akreager/cartreader/README.md

   

# Open Source Cartridge Reader
This project represents a community-driven effort to provide an easy to build and easy to modify cartridge dumper.     
Its main purpose is to dump a video game's ROM and save file to an SD card without the need of a PC.    

For any questions you can use the [Discussions](https://github.com/sanni/cartreader/discussions) and/or [Issues](https://github.com/sanni/cartreader/issues) section here on Github or visit the accompanying thread in the [Arduino Forum](http://forum.arduino.cc/index.php?topic=158974.9001), where you can reach most of the devs directly.    

Also be sure to check the guides in the [Wiki](https://github.com/sanni/cartreader/wiki) too.    

Happy making. 🔧🔨😊    

   

#### Features:  
- Modular design   
- Stand-alone operation  
- Easy to modify open-source code      
- Portable when used together with a power bank  

   

#### Supported Systems:    
- NES/Famicom/Family Basic   
- SNES/Super Famicom (including SF Memory and Satellaview)  
- N64 (including Controller Pak and Gameshark)     
- Game Boy Color (including GB Memory)  
- Game Boy Advance    
- Sega Mega Drive/Genesis    
- Sega Master System   

  

#### Supported with adapters:    
- Virtual Boy    
- Sega Game Gear    
- Sega Mark III     
- Sega SG-1000    
- Sega Cards    
- PC engine/TG16    
- WonderSwan    
- NeoGeo Pocket    
- Intellivision   
- ColecoVision    
- Benesse Pocket Challenge W    
- Watara Supervision    
- Atari 2600    
- Emerson Arcadia 2001   
- Fairchild Channel F     
- Magnavox Odyssey 2     

#### Open Source Licenses:    
- Software(everything in Cart_Reader folder) = GPL v3   
- Hardware(everything in hardware folder) = CC-BY-4.0
