akreager/cartreader/hardware/main_pcb_hw5/main_pcb_hw5.kicad_pcb

## KiCad design hardware/main_pcb_hw5/main_pcb_hw5.kicad_pcb (2023-01-22)

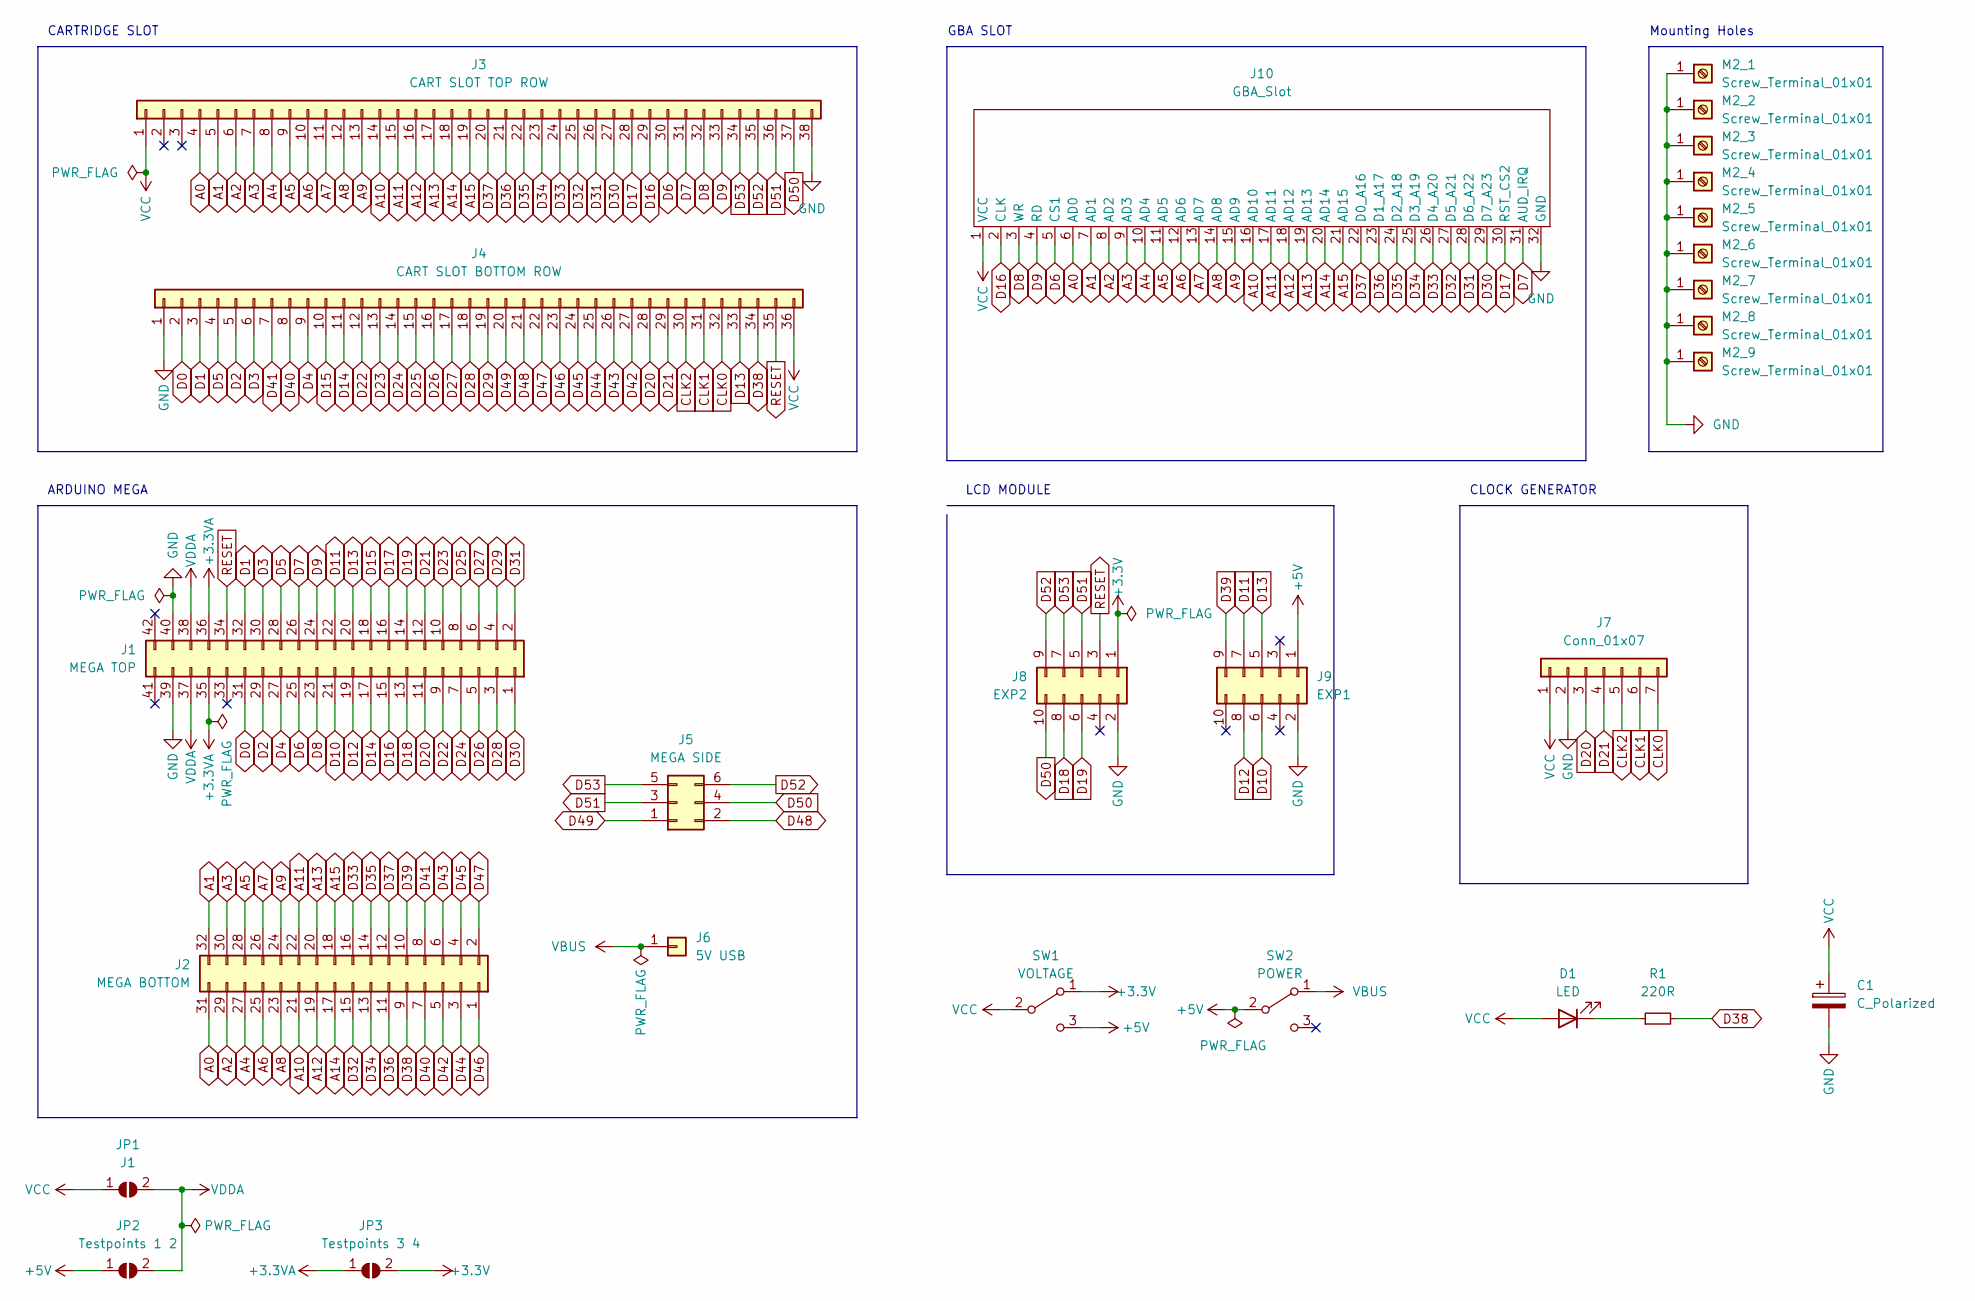
[picture p1: schematic main_pcb_hw5.kicad_sch, OSCR HW5]

Parts:
C1: C_Polarized; CP_Radial_D8.0mm_P3.50mm
D1: LED; LED_D3.0mm
J1: MEGA TOP; PinSocket_2x21_P2.54mm_Vertical
J2: MEGA BOTTOM; PinSocket_2x16_P2.54mm_Vertical
J3: CART SLOT TOP ROW; PinSocket_1x38_P2.54mm_Vertical
J4: CART SLOT BOTTOM ROW; PinSocket_1x36_P2.54mm_Vertical
J5: MEGA SIDE; PinSocket_2x03_P2.54mm_Vertical
J6: 5V USB; PinHeader_1x01_P2.54mm_Vertical
J7: Conn_01x07; PinHeader_1x07_P2.54mm_Vertical
J8: EXP2; IDC-Header_2x05_P2.54mm_Vertical
J9: EXP1; IDC-Header_2x05_P2.54mm_Vertical
J10: GBA_Slot
JP1: J1; SolderJumper-2_P1.3mm_Open_Pad1.0x1.5mm
JP2: Testpoints 1 2; SolderJumper-2_P1.3mm_Open_Pad1.0x1.5mm
JP3: Testpoints 3 4; SolderJumper-2_P1.3mm_Open_Pad1.0x1.5mm
M2_1, M2_2, M2_3, M2_4, M2_5, M2_6, M2_7, M2_8, M2_9: Screw_Terminal_01x01; MountingHole_2.2mm_M2_ISO7380_Pad
R1: 220R; R_Axial_DIN0207_L6.3mm_D2.5mm_P10.16mm_Horizontal
SW1: VOLTAGE; SW_CuK_OS102011MA1QN1_SPDT_Angled
SW2: POWER; SW_CuK_OS102011MA1QN1_SPDT_Angled

Connections:
+3.3VA: J1.35, J1.36, JP3.1 (A)
+3V3: J8.1, JP3.2 (B), SW1.1 (A)
+5V: J9.1, JP2.1 (A), SW1.3 (C), SW2.2 (B)
A0: J2.31, J3.4, J10.6 (AD0)
A1: J2.32, J3.5, J10.7 (AD1)
A2: J2.29, J3.6, J10.8 (AD2)
A3: J2.30, J3.7, J10.9 (AD3)
A4: J2.27, J3.8, J10.10 (AD4)
A5: J2.28, J3.9, J10.11 (AD5)
A6: J2.25, J3.10, J10.12 (AD6)
A7: J2.26, J3.11, J10.13 (AD7)
A8: J2.23, J3.12, J10.14 (AD8)
A9: J2.24, J3.13, J10.15 (AD9)
A10: J2.21, J3.14, J10.16 (AD10)
A11: J2.22, J3.15, J10.17 (AD11)
A12: J2.19, J3.16, J10.18 (AD12)
A13: J2.20, J3.17, J10.19 (AD13)
A14: J2.17, J3.18, J10.20 (AD14)
A15: J2.18, J3.19, J10.21 (AD15)
CLK0: J4.32, J7.7
CLK1: J4.31, J7.6
CLK2: J4.30, J7.5
D0: J1.31, J4.2
D1: J1.32, J4.3
D2: J1.29, J4.5
D3: J1.30, J4.6
D4: J1.27, J4.9
D5: J1.28, J4.4
D6: J1.25, J3.30, J10.5 (CS1)
D7: J1.26, J3.31, J10.31 (AUD_IRQ)
D8: J1.23, J3.32, J10.3 (WR)
D9: J1.24, J3.33, J10.4 (RD)
D10: J1.21, J9.6
D11: J1.22, J9.7
D12: J1.19, J9.8
D13: J1.20, J4.33, J9.5
D14: J1.17, J4.11
D15: J1.18, J4.10
D16: J1.15, J3.29, J10.2 (CLK)
D17: J1.16, J3.28, J10.30 (RST_CS2)
D18: J1.13, J8.8
D19: J1.14, J8.6
D20: J1.11, J4.28, J7.3
D21: J1.12, J4.29, J7.4
D22: J1.9, J4.12
D23: J1.10, J4.13
D24: J1.7, J4.14
D25: J1.8, J4.15
D26: J1.5, J4.16
D27: J1.6, J4.17
D28: J1.3, J4.18
D29: J1.4, J4.19
D30: J1.1, J3.27, J10.29 (D7_A23)
D31: J1.2, J3.26, J10.28 (D6_A22)
D32: J2.15, J3.25, J10.27 (D5_A21)
D33: J2.16, J3.24, J10.26 (D4_A20)
D34: J2.13, J3.23, J10.25 (D3_A19)
D35: J2.14, J3.22, J10.24 (D2_A18)
D36: J2.11, J3.21, J10.23 (D1_A17)
D37: J2.12, J3.20, J10.22 (D0_A16)
D38: J2.9, J4.34, R1.2
D39: J2.10, J9.9
D40: J2.7, J4.8
D41: J2.8, J4.7
D42: J2.5, J4.27
D43: J2.6, J4.26
D44: J2.3, J4.25
D45: J2.4, J4.24
D46: J2.1, J4.23
D47: J2.2, J4.22
D48: J4.21, J5.2
D49: J4.20, J5.1
D50: J3.37, J5.4, J8.10
D51: J3.36, J5.3, J8.5
D52: J3.35, J5.6, J8.9
D53: J3.34, J5.5, J8.7
GND: C1.2, J1.39, J1.40, J3.38, J4.1, J7.2, J8.2, J9.2, J10.32 (GND), M2_1.1, M2_2.1, M2_3.1, M2_4.1, M2_5.1, M2_6.1, M2_7.1, M2_8.1, M2_9.1
unnamed: D1.1 (K), R1.1
RESET: J1.34, J4.35, J8.3
VBUS: J6.1, SW2.1 (A)
VCC: C1.1, D1.2 (A), J3.1, J4.36, J7.1, J10.1 (VCC), JP1.1 (A), SW1.2 (B)
VDDA: J1.37, J1.38, JP1.2 (B), JP2.2 (B)

Notes on the sheet:
LCD MODULE
CLOCK GENERATOR
CARTRIDGE SLOT
GBA SLOT
ARDUINO MEGA
Mounting Holes

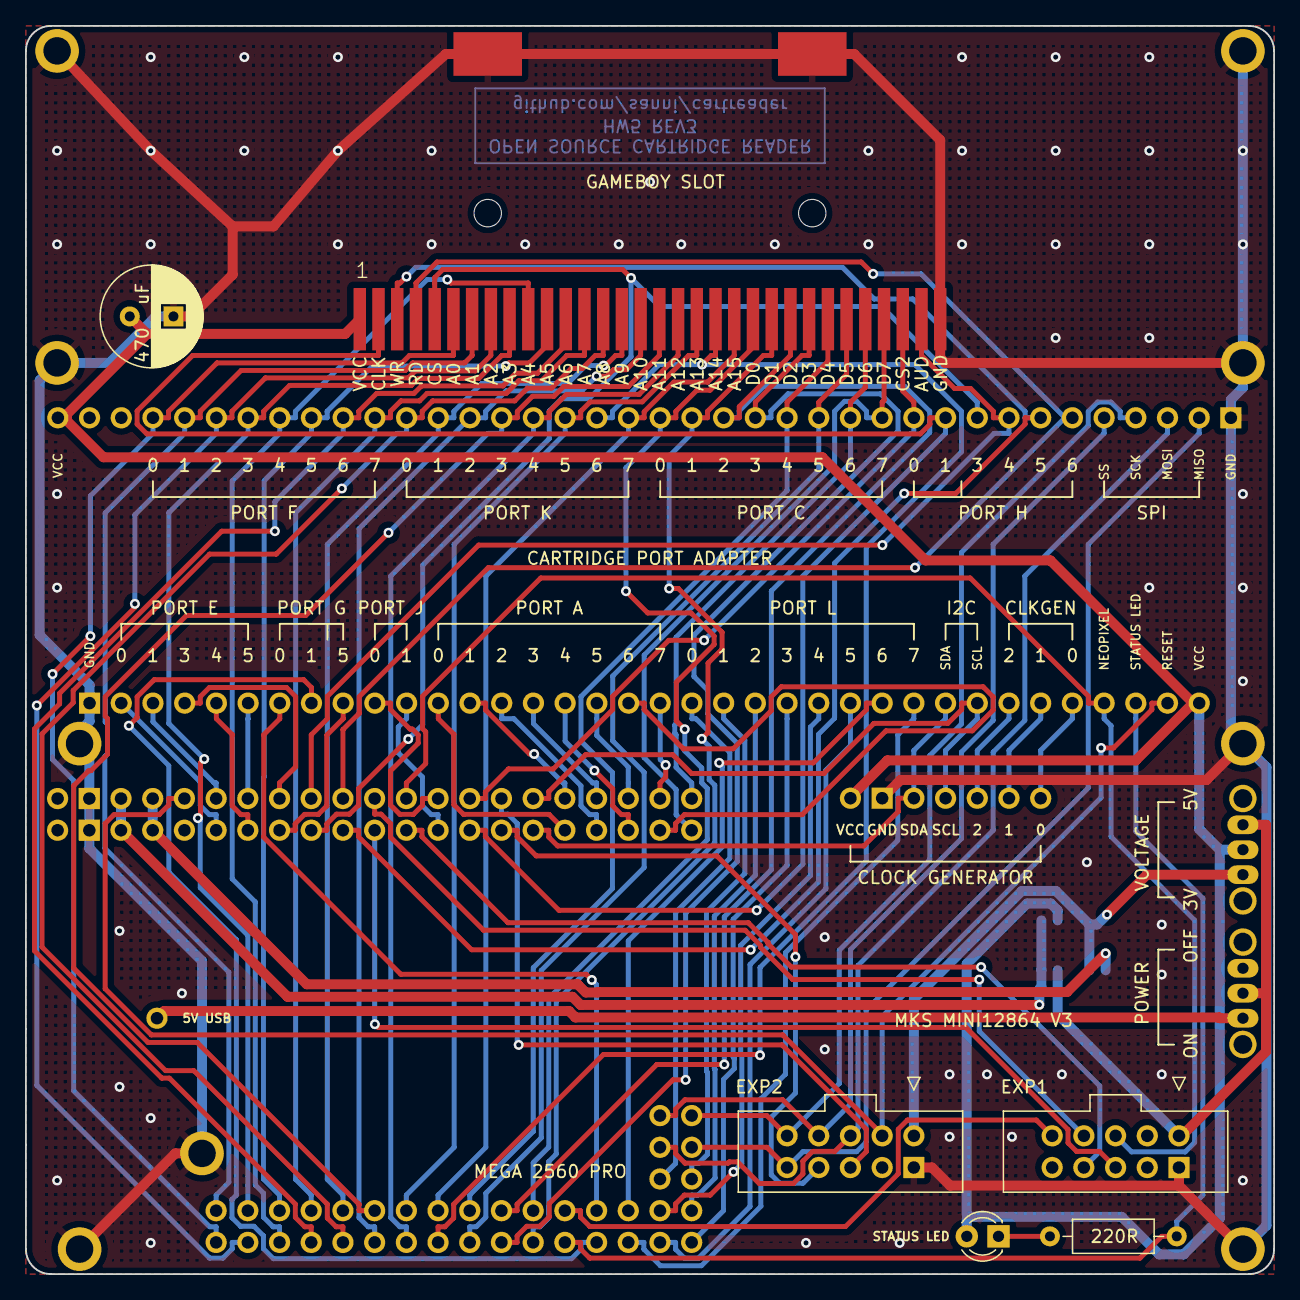
[picture p2: board main_pcb_hw5.kicad_pcb from above]

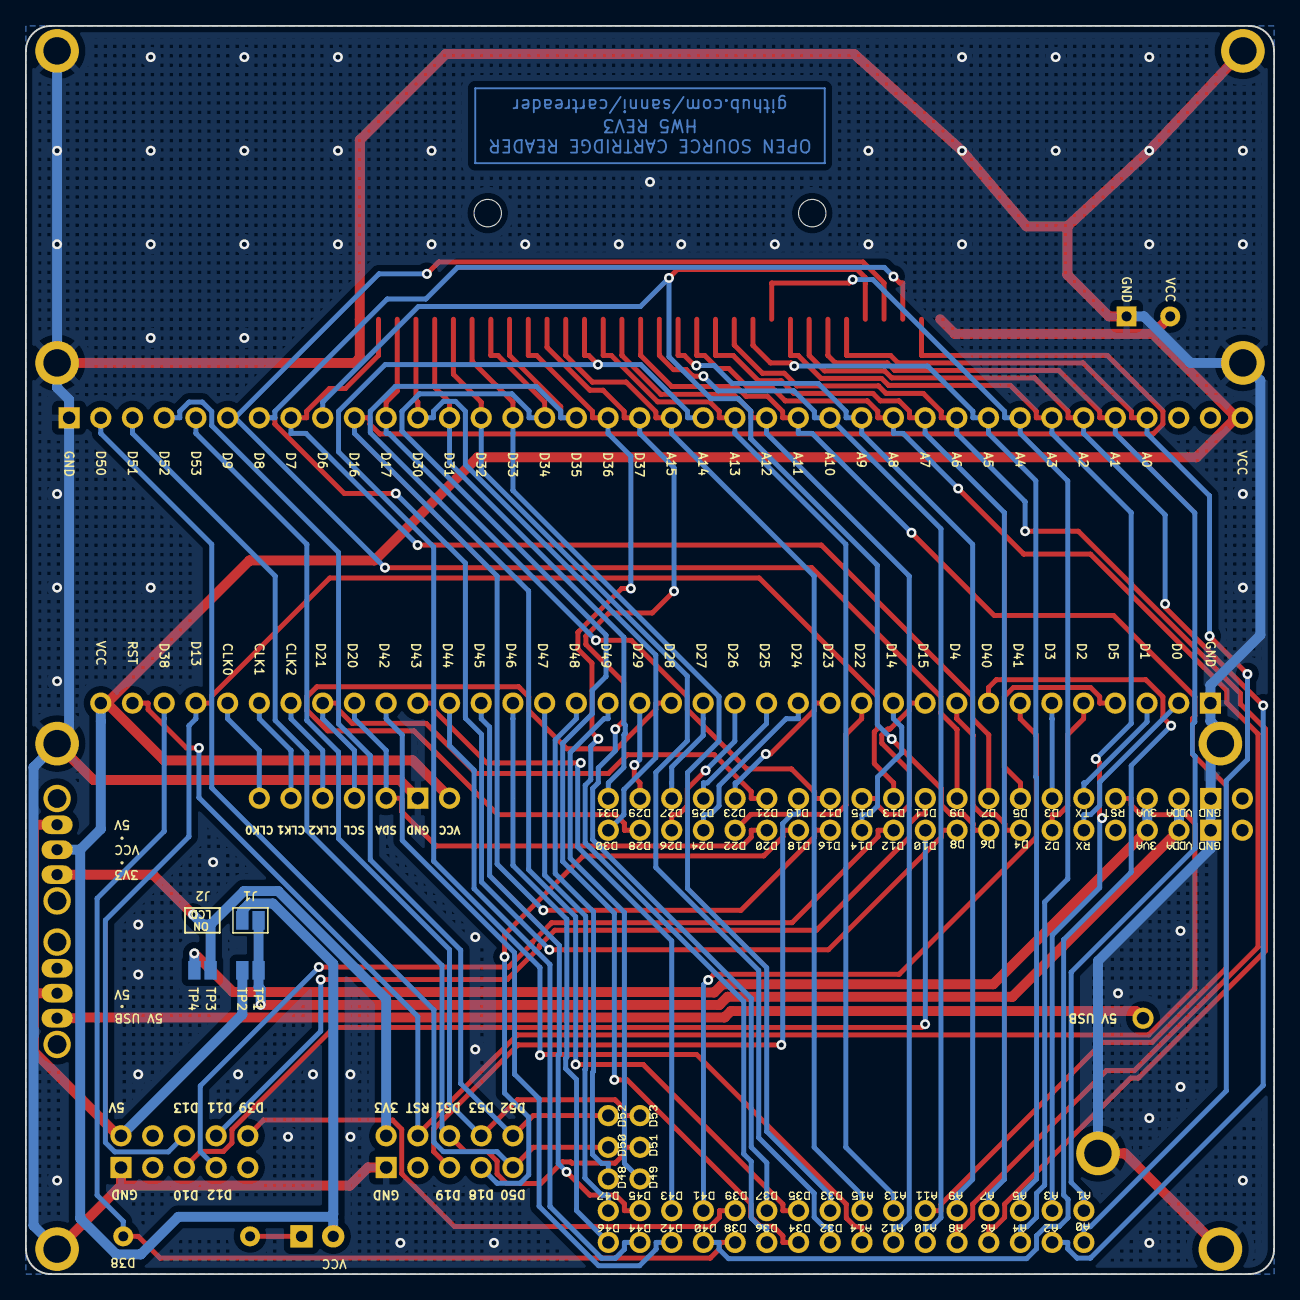
[picture p3: board main_pcb_hw5.kicad_pcb from below]

Board: 2 copper layers, 100.0 x 100.0 mm, 27 parts (3 on the bottom side), 82 nets.
