akreager/cartreader/Cart_Reader/NES.ino

//******************************************
// NES MODULE
//******************************************
// mostly copy&pasted from "Famicom Dumper" 2019-08-31 by skaman
// also based on "CoolArduino" by HardWareMan
// Pinout changes: LED and CIRAM_A10

#ifdef enable_NES

//Line Content
//28   Supported Mappers
//106  Defines
//136  Variables
//197  Menus
//383  Setup
//412  No-Intro SD Database Functions
//1125 Low Level Functions
//1372 CRC Functions
//1426 File Functions
//1527 NES 2.0 Header Functions
//1957 Config Functions
//2760 ROM Functions
//3951 RAM Functions
//4384 Eeprom Functions
//4574 NESmaker Flash Cart Functions

/******************************************
  Supported Mappers
 *****************************************/
// Supported Mapper Array (iNES Mapper #s)
// Format = {mapper,prglo,prghi,chrlo,chrhi,ramlo,ramhi}
static const byte PROGMEM mapsize[] = {
  0, 0, 1, 0, 1, 0, 2,   // nrom                                                [sram r/w]
  1, 1, 5, 0, 5, 0, 3,   // mmc1                                                [sram r/w]
  2, 2, 4, 0, 0, 0, 0,   // uxrom
  3, 0, 1, 0, 3, 0, 0,   // cnrom
  4, 1, 5, 0, 6, 0, 1,   // mmc3/mmc6                                           [sram/prgram r/w]
  5, 3, 5, 5, 7, 0, 3,   // mmc5                                                [sram r/w]
  7, 2, 4, 0, 0, 0, 0,   // axrom
  9, 3, 3, 5, 5, 0, 0,   // mmc2 (punch out)
  10, 3, 4, 4, 5, 1, 1,  // mmc4                                               [sram r/w]
  11, 1, 3, 1, 5, 0, 0,  // Color Dreams [UNLICENSED]
  13, 1, 1, 0, 0, 0, 0,  // cprom (videomation)
  15, 6, 6, 0, 0, 0, 0,  // K-1029/K-1030P [UNLICENSED]
  16, 3, 4, 5, 6, 0, 1,  // bandai x24c02                                      [eep r/w]
  18, 3, 4, 5, 6, 0, 1,  // jaleco ss8806                                      [sram r/w]
  19, 3, 4, 5, 6, 0, 1,  // namco 106/163                                      [sram/prgram r/w]
  // 20 - bad mapper, not used
  21, 4, 4, 5, 6, 0, 1,  // vrc4a/vrc4c                                        [sram r/w]
  22, 3, 3, 5, 5, 0, 0,  // vrc2a
  23, 3, 3, 5, 6, 0, 0,  // vrc2b/vrc4e
  24, 4, 4, 5, 5, 0, 0,  // vrc6a (akumajou densetsu)
  25, 3, 4, 5, 6, 0, 1,  // vrc2c/vrc4b/vrc4d                                  [sram r/w]
  26, 4, 4, 5, 6, 1, 1,  // vrc6b                                              [sram r/w]
  28, 5, 7, 0, 0, 0, 0,  // Action 53 [UNLICENSED]
  30, 4, 5, 0, 0, 0, 0,  // unrom 512 (NESmaker) [UNLICENSED]
  31, 6, 6, 0, 0, 0, 0,  // NSF music compilations [UNLICENSED]
  32, 3, 4, 5, 5, 0, 0,  // irem g-101
  33, 3, 4, 5, 6, 0, 0,  // taito tc0190
  34, 3, 5, 0, 0, 0, 0,  // bnrom [nina-1 NOT SUPPORTED]
  35, 0, 7, 1, 8, 0, 0,  // J.Y. Company ASIC [UNLICENSED]
  36, 0, 3, 1, 5, 0, 0,  // TXC 01-22000-400 Board [UNLICENSED]
  37, 4, 4, 6, 6, 0, 0,  // (super mario bros + tetris + world cup)
  42, 0, 3, 0, 5, 0, 0,  // hacked FDS games converted to cartridge [UNLICENSED]
  45, 3, 6, 0, 8, 0, 0,  // ga23c asic multicart [UNLICENSED]
  46, 1, 6, 0, 8, 0, 0,  // Rumble Station [UNLICENSED]
  47, 4, 4, 6, 6, 0, 0,  // (super spike vball + world cup)
  48, 3, 4, 6, 6, 0, 0,  // taito tc0690
  52, 0, 3, 0, 3, 0, 0,  // Realtec 8213 [UNLICENSED]
  56, 0, 7, 0, 6, 0, 0,  // KS202 [UNLICENSED]
  57, 0, 3, 0, 5, 0, 0,  // BMC-GKA [UNLICENSED]
  58, 1, 6, 1, 6, 0, 0,  // BMC-GKB (C)NROM-based multicarts, duplicate of mapper 213 [UNLICENSED]
  59, 0, 3, 0, 4, 0, 0,  // BMC-T3H53 & BMC-D1038 [UNLICENSED]
  60, 2, 2, 3, 3, 0, 0,  // Reset-based NROM-128 4-in-1 multicarts [UNLICENSED]
  62, 7, 7, 8, 8, 0, 0,  // K-1017P [UNLICENSED]
  63, 8, 8, 0, 0, 0, 0,  // NTDEC "Powerful" multicart, 3072K [UNLICENSED]
  64, 2, 3, 4, 5, 0, 0,  // tengen rambo-1 [UNLICENSED]
  65, 3, 4, 5, 6, 0, 0,  // irem h-3001
  66, 2, 3, 2, 3, 0, 0,  // gxrom/mhrom
  67, 3, 3, 5, 5, 0, 0,  // sunsoft 3
  68, 3, 3, 5, 6, 0, 1,  // sunsoft 4                                          [sram r/w]
  69, 3, 4, 5, 6, 0, 1,  // sunsoft fme-7/5a/5b                                [sram r/w]
  70, 3, 3, 5, 5, 0, 0,  // bandai
  71, 2, 4, 0, 0, 0, 0,  // camerica/codemasters [UNLICENSED]
  72, 3, 3, 5, 5, 0, 0,  // jaleco jf-17
  73, 3, 3, 0, 0, 0, 0,  // vrc3 (salamander)
  75, 3, 3, 5, 5, 0, 0,  // vrc1
  76, 3, 3, 5, 5, 0, 0,  // namco 109 variant (megami tensei: digital devil story)
  77, 3, 3, 3, 3, 0, 0,  // (napoleon senki)
  78, 3, 3, 5, 5, 0, 0,  // irem 74hc161/32
  79, 1, 2, 2, 3, 0, 0,  // NINA-03/06 by AVE [UNLICENSED]
  80, 3, 3, 5, 6, 0, 1,  // taito x1-005                                       [prgram r/w]
  82, 3, 3, 5, 6, 0, 1,  // taito x1-017                                       [prgram r/w]
  // 84 - bad mapper, not used
  85, 3, 5, 0, 5, 0, 1,  // vrc7                                               [sram r/w]
  86, 3, 3, 4, 4, 0, 0,  // jaleco jf-13 (moero pro yakyuu)
  87, 0, 1, 2, 3, 0, 0,  // Jaleco/Konami CNROM (DIS_74X139X74)
  88, 3, 3, 5, 5, 0, 0,  // namco (dxrom variant)
  89, 3, 3, 5, 5, 0, 0,  // sunsoft 2 variant (tenka no goikenban: mito koumon)
  90, 0, 7, 1, 8, 0, 0,  // J.Y. Company ASIC [UNLICENSED]
  91, 3, 5, 7, 8, 0, 0,  // JY830623C/YY840238C boards [UNLICENSED]
  92, 4, 4, 5, 5, 0, 0,  // jaleco jf-19/jf-21
  93, 3, 3, 0, 0, 0, 0,  // sunsoft 2
  94, 3, 3, 0, 0, 0, 0,  // hvc-un1rom (senjou no ookami)
  95, 3, 3, 3, 3, 0, 0,  // namcot-3425 (dragon buster)
  96, 3, 3, 0, 0, 0, 0,  // (oeka kids)
  97, 4, 4, 0, 0, 0, 0,  // irem tam-s1 (kaiketsu yanchamaru)
  // 100 - bad mapper, not used
  // 101 - bad mapper, not used
  105, 4, 4, 0, 0, 0, 0,  // (nintendo world Championships 1990) [UNTESTED]
  113, 1, 4, 0, 5, 0, 0,  // NINA-03/06 [UNLICENSED]
  111, 5, 5, 0, 0, 0, 0,  // GTROM [UNLICENSED]
  118, 3, 4, 5, 5, 0, 1,  // txsrom/mmc3                                       [sram r/w]
  119, 3, 3, 4, 4, 0, 0,  // tqrom/mmc3
  126, 1, 8, 0, 8, 0, 0,  // MMC3-based multicart (PJ-008, AT-207) [UNLICENSED]
  134, 1, 8, 0, 8, 0, 0,  // T4A54A, WX-KB4K, or BS-5652 [UNLICENSED]
  140, 3, 3, 3, 5, 0, 0,  // jaleco jf-11/jf-14
  142, 1, 3, 0, 0, 0, 0,  // UNL-KS7032 [UNLICENSED]
  146, 1, 2, 2, 3, 0, 0,  // Sachen 3015 [UNLICENSED]
  // 151 - bad mapper, not used
  152, 2, 3, 5, 5, 0, 0,  // BANDAI-74*161/161/32
  153, 5, 5, 0, 0, 1, 1,  // (famicom jump ii)                                 [sram r/w]
  154, 3, 3, 5, 5, 0, 0,  // namcot-3453 (devil man)
  155, 3, 3, 3, 5, 0, 1,  // mmc1 variant                                      [sram r/w]
  157, 4, 4, 0, 0, 0, 0,  // Datach
  158, 3, 3, 5, 5, 0, 0,  // tengen rambo-1 variant (alien syndrome (u)) [UNLICENSED]
  159, 3, 4, 5, 6, 1, 1,  // bandai x24c01                                     [eep r/w]
  162, 6, 7, 0, 0, 0, 0,  // Waixing FS304 [UNLICENSED]
  163, 6, 7, 0, 0, 0, 0,  // Nanjing FC-001 [UNLICENSED]
  174, 3, 3, 4, 4, 0, 0,  // NTDEC 5-in-1 [UNLICENSED]
  176, 4, 4, 5, 5, 0, 0,  // 8025 enhanced MMC3 [UNLICENSED]
  177, 1, 7, 0, 0, 0, 0,  // Henggedianzi Super Rich PCB [UNLICENSED]
  178, 5, 5, 0, 0, 0, 0,  // some Waixing PCBs [UNLICENSED]
  180, 3, 3, 0, 0, 0, 0,  // unrom variant (crazy climber)
  184, 1, 1, 2, 3, 0, 0,  // sunsoft 1
  185, 0, 1, 1, 1, 0, 0,  // cnrom lockout
  // 186 - bad mapper, not used
  200, 1, 4, 1, 4, 0, 0,  // HN-02 multicarts [UNLICENSED]
  201, 1, 8, 1, 9, 0, 0,  // NROM-256 multicarts [UNLICENSED]
  202, 0, 3, 1, 4, 0, 0,  // BMC-150IN1 multicarts [UNLICENSED]
  203, 1, 4, 1, 4, 0, 0,  // various NROM-128 multicarts [UNLICENSED]
  206, 1, 3, 2, 4, 0, 0,  // dxrom
  207, 4, 4, 5, 5, 0, 0,  // taito x1-005 variant (fudou myouou den)
  209, 0, 7, 1, 8, 0, 0,  // J.Y. Company ASIC [UNLICENSED]
  210, 3, 5, 5, 6, 0, 0,  // namco 175/340
  211, 0, 7, 1, 8, 0, 0,  // J.Y. Company ASIC [UNLICENSED]
  212, 0, 3, 0, 4, 0, 0,  // BMC Super HiK 300-in-1 [UNLICENSED]
  213, 1, 6, 1, 6, 0, 0,  // BMC-GKB (C)NROM-based multicarts, duplicate of mapper 58 [UNLICENSED]
  214, 0, 3, 0, 4, 0, 0,  // BMC-SUPERGUN-20IN1, BMC-190IN1 [UNLICENSED]
  225, 4, 7, 5, 8, 0, 0,  // ET-4310 (FC) + K-1010 (NES) [UNLICENSED]
  226, 6, 7, 0, 0, 0, 0,  // BMC-76IN1, BMC-SUPER42IN1, BMC-GHOSTBUSTERS63IN1 [UNLICENSED]
  227, 1, 5, 0, 0, 0, 0,  // 810449-C-A1 / FW-01 [UNLICENSED]
  228, 4, 7, 5, 7, 0, 0,  // Action 52 + Cheetahmen II [UNLICENSED]
  229, 5, 5, 6, 6, 0, 0,  // BMC 31-IN-1 [UNLICENSED]
  232, 4, 4, 0, 0, 0, 0,  // Camerica/Codemasters "Quattro" cartridges [UNLICENSED]
  235, 6, 8, 0, 0, 0, 0,  // "Golden Game" multicarts [UNLICENSED]
  236, 0, 6, 0, 5, 0, 0,  // Realtec 8031, 8099, 8106, 8155 [UNLICENSED]
  240, 1, 5, 1, 5, 0, 3,  // C&E Bootleg Board (Sheng Huo Lie Zhuan, Jing Ke Xin Zhuan) [UNLICENSED]
  241, 3, 5, 0, 0, 0, 0,  // BxROM with WRAM [UNLICENSED]
  242, 5, 5, 0, 0, 0, 0,  // ET-113 [UNLICENSED]
  246, 5, 5, 7, 7, 0, 0,  // C&E Feng Shen Bang [UNLICENSED]
  // 248 - bad mapper, not used
  255, 4, 7, 5, 8, 0, 0,  // 110-in-1 multicart (same as 225) [UNLICENSED]
};

const char _file_name_no_number_fmt[] PROGMEM = "%s.%s";
const char _file_name_with_number_fmt[] PROGMEM = "%s.%02d.%s";

/******************************************
  Defines
 *****************************************/
#define ROMSEL_HI PORTF |= (1 << 1)
#define ROMSEL_LOW PORTF &= ~(1 << 1)
#define PHI2_HI PORTF |= (1 << 0)
#define PHI2_LOW PORTF &= ~(1 << 0)
#define PRG_READ PORTF |= (1 << 7)
#define PRG_WRITE PORTF &= ~(1 << 7)
#define CHR_READ_HI PORTF |= (1 << 5)
#define CHR_READ_LOW PORTF &= ~(1 << 5)
#define CHR_WRITE_HI PORTF |= (1 << 2)
#define CHR_WRITE_LOW PORTF &= ~(1 << 2)

// RGB LED COMMON ANODE
#define LED_RED_OFF setColor_RGB(0, 0, 0)
#define LED_RED_ON setColor_RGB(255, 0, 0)
#define LED_GREEN_OFF setColor_RGB(0, 0, 0)
#define LED_GREEN_ON setColor_RGB(0, 255, 0)
#define LED_BLUE_OFF setColor_RGB(0, 0, 0)
#define LED_BLUE_ON setColor_RGB(0, 0, 255)

#define MODE_READ \
  { \
    PORTK = 0xFF; \
    DDRK = 0; \
  }
#define MODE_WRITE DDRK = 0xFF

#define press 1
#define doubleclick 2
#define hold 3
#define longhold 4

/******************************************
  Variables
*****************************************/
// Mapper
byte mapcount = (sizeof(mapsize) / sizeof(mapsize[0])) / 7;
byte mapselect;

const int PRG[] PROGMEM = { 16, 32, 64, 128, 256, 512, 1024, 2048, 4096 };
byte prglo = 0;  // Lowest Entry
byte prghi = 8;  // Highest Entry

const int CHR[] PROGMEM = { 0, 8, 16, 32, 64, 128, 256, 512, 1024 };
byte chrlo = 0;  // Lowest Entry
byte chrhi = 8;  // Highest Entry

const byte RAM[] PROGMEM = { 0, 8, 16, 32 };
byte ramlo = 0;  // Lowest Entry
byte ramhi = 3;  // Highest Entry

int banks;
int prg;
int chr;
byte ram;
boolean vrc4e = false;
byte prgchk0;
byte prgchk1;
boolean mmc6 = false;
byte prgchk2;
byte prgchk3;
word eepsize;
byte bytecheck;
byte firstbyte;
boolean flashfound = false;  // NESmaker 39SF040 Flash Cart

// Cartridge Config
byte mapper;
byte prgsize;
byte newprgsize;
byte chrsize;
byte newchrsize;
byte ramsize;
byte newramsize;

/******************************************
  Menus
*****************************************/
// NES start menu
static const char nesMenuItem1[] PROGMEM = "Read iNES Rom";
static const char nesMenuItem2[] PROGMEM = "Read PRG/CHR";
static const char nesMenuItem3[] PROGMEM = "Read Sram";
static const char nesMenuItem4[] PROGMEM = "Write Sram";
static const char nesMenuItem5[] PROGMEM = "Change Mapper";
static const char nesMenuItem6[] PROGMEM = "Flash NESMaker";
//static const char nesMenuItem7[] PROGMEM = "Reset"; (stored in common strings array)
static const char* const menuOptionsNES[] PROGMEM = { nesMenuItem1, nesMenuItem2, nesMenuItem3, nesMenuItem4, nesMenuItem5, nesMenuItem6, string_reset2 };

// NES chips menu
#ifndef nointro
static const char nesChipsMenuItem1[] PROGMEM = "Read PRG & CHR";
#else
static const char nesChipsMenuItem1[] PROGMEM = "Combined PRG+CHR";
#endif
static const char nesChipsMenuItem2[] PROGMEM = "Read only PRG";
static const char nesChipsMenuItem3[] PROGMEM = "Read only CHR";
static const char nesChipsMenuItem4[] PROGMEM = "Back";
static const char* const menuOptionsNESChips[] PROGMEM = { nesChipsMenuItem1, nesChipsMenuItem2, nesChipsMenuItem3, nesChipsMenuItem4 };

// NES start menu
void nesMenu() {
  vselect(false);
  unsigned char answer;

  // create menu with title "NES CART READER" and 7 options to choose from
  convertPgm(menuOptionsNES, 7);
  answer = question_box(F("NES CART READER"), menuOptions, 7, 0);

  // wait for user choice to come back from the question box menu
  switch (answer) {
    // Read Rom
    case 0:
#ifndef nointro
      CartStart();
      readPRG(false);
      delay(2000);
      readCHR(false);
      delay(2000);
      outputNES();
      delay(2000);
      readRAM();
      delay(2000);
      resetROM();
      CartFinish();
#else
      display_Clear();
      // Change working dir to root
      sd.chdir("/");
      readRom_NES();
      println_Msg(F(""));
      // Prints string out of the common strings array either with or without newline
      print_STR(press_button_STR, 1);
#ifdef global_log
      save_log();
#endif
      display_Update();
      wait();
#endif
      break;

    // Read single chip
    case 1:
      nesChipMenu();
      break;

    // Read RAM
    case 2:
      CreateROMFolderInSD();
      readRAM();
      resetROM();
      println_Msg(F(""));
      // Prints string out of the common strings array either with or without newline
      print_STR(press_button_STR, 1);
      display_Update();
      wait();
      break;

    // Write RAM
    case 3:
      writeRAM();
      resetROM();
      println_Msg(F(""));
      // Prints string out of the common strings array either with or without newline
      print_STR(press_button_STR, 1);
      display_Update();
      wait();
      break;

    // Change Mapper
    case 4:
      setDefaultRomName();
      setMapper();
      checkMapperSize();
      setPRGSize();
      setCHRSize();
      setRAMSize();
      checkStatus_NES();
      break;

    // Write FLASH
    case 5:
      if (mapper == 30) {
        writeFLASH();
        resetROM();
      } else {
        display_Clear();
        println_Msg(F("Error:"));
        println_Msg(F("Can't write to this cartridge"));
        println_Msg(F(""));
        // Prints string out of the common strings array either with or without newline
        print_STR(press_button_STR, 1);
        display_Update();
      }
      wait();
      break;

    // Reset
    case 6:
      resetArduino();
      break;
  }
}

void nesChipMenu() {
  // create menu with title "Select NES Chip" and 4 options to choose from
  convertPgm(menuOptionsNESChips, 4);
  unsigned char answer = question_box(F("Select NES Chip"), menuOptions, 4, 0);

  // wait for user choice to come back from the question box menu
  switch (answer) {
    // Read combined PRG/CHR
    case 0:
#ifndef nointro
      CreateROMFolderInSD();
      readPRG(false);
      resetROM();

      CreateROMFolderInSD();
      readCHR(false);
      resetROM();

      println_Msg(F(""));
      // Prints string out of the common strings array either with or without newline
      print_STR(press_button_STR, 1);
#else
      display_Clear();
      // Change working dir to root
      sd.chdir("/");
      readRaw_NES();
      println_Msg(F(""));
      // Prints string out of the common strings array either with or without newline
      print_STR(press_button_STR, 1);
#ifdef global_log
      save_log();
#endif
#endif
      display_Update();
      wait();
      break;

    // Read PRG
    case 1:
      CreateROMFolderInSD();
      readPRG(false);
      resetROM();
      println_Msg(F(""));
      // Prints string out of the common strings array either with or without newline
      print_STR(press_button_STR, 1);
      display_Update();
      wait();
      break;

    // Read CHR
    case 2:
      CreateROMFolderInSD();
      readCHR(false);
      resetROM();
      println_Msg(F(""));
      // Prints string out of the common strings array either with or without newline
      print_STR(press_button_STR, 1);
      display_Update();
      wait();
      break;

    // Return to Main Menu
    case 3:
      nesMenu();
      wait();
      break;
  }
}

/******************************************
   Setup
 *****************************************/
void setup_NES() {
  // CPU R/W, IRQ, PPU /RD, PPU /A13, CIRAM /CE, PPU /WR, /ROMSEL, PHI2
  DDRF = 0b10110111;
  // CPU R/W, IRQ, PPU /RD, PPU /A13, CIRAM /CE, PPU /WR, /ROMSEL, PHI2
  PORTF = 0b11111111;

  // A0-A7 to Output
  DDRL = 0xFF;
  // A8-A14 to Output
  DDRA = 0xFF;

  // Set CIRAM A10 to Input
  DDRC &= ~(1 << 2);
  // Activate Internal Pullup Resistors
  PORTC |= (1 << 2);

  // Set D0-D7 to Input
  PORTK = 0xFF;
  DDRK = 0;

  set_address(0);
  LED_RED_OFF;
  LED_GREEN_OFF;
  LED_BLUE_OFF;
}

/******************************************
   Get Mapping from nointro SD database
 *****************************************/
#ifdef nointro
// no clue (taken from fceux)
uint32_t uppow2(uint32_t n) {
  int x;

  for (x = 31; x >= 0; x--)
    if (n & (1u << x)) {
      if ((1u << x) != n)
        return (1u << (x + 1));
      break;
    }
  return n;
}

struct database_entry {
  char filename[128];
  char crc_str[8 + 1 + 8 + 1 + 32 + 1];
  uint32_t crc;
  char* crc512_str;
  uint32_t crc512;
  char* iNES_str;
};

void printPRG(unsigned long myOffset) {
  display_Clear();
  print_Msg(F("Printing PRG at "));
  println_Msg(myOffset);

  char myBuffer[3];

  for (word currLine = 0; currLine < 512; currLine += 16) {
    for (byte currByte = 0; currByte < 16; currByte++) {
      itoa(read_prg_byte(myOffset + currLine + currByte), myBuffer, 16);
      for (word i = 0; i < 2 - strlen(myBuffer); i++) {
        print_Msg(F("0"));
      }
      // Now print the significant bits
      print_Msg(myBuffer);
      print_Msg(" ");
    }
    println_Msg("");
  }
  display_Update();
}

void setDefaultRomName() {
  romName[0] = 'C';
  romName[1] = 'A';
  romName[2] = 'R';
  romName[3] = 'T';
  romName[4] = '\0';
}

void setRomnameFromString(const char* input) {
  byte myLength = 0;
  for (byte i = 0; i < 20 && myLength < 15; i++) {
    // Stop at first "(" to remove "(Country)"
    if (input[i] == '(') {
      break;
    }
    if (
      (input[i] >= '0' && input[i] <= '9') || (input[i] >= 'A' && input[i] <= 'Z') || (input[i] >= 'a' && input[i] <= 'z')) {
      romName[myLength++] = input[i];
    }
  }

  // If name consists out of all japanese characters use CART as name
  if (myLength == 0) {
    setDefaultRomName();
  }
}

void getMapping() {
  FsFile database;
  uint32_t oldcrc32 = 0xFFFFFFFF;
  uint32_t oldcrc32MMC3 = 0xFFFFFFFF;
  char crcStr[9];

  display_Clear();

  sd.chdir();
  if (!database.open("nes.txt", O_READ)) {
    print_FatalError(F("Database file not found"));
    // never reached
  }

  // Read first 512 bytes of first and last block of PRG ROM and compute CRC32
  // MMC3 maps the last 8KB block of PRG ROM to 0xE000 while 0x8000 can contain random data after bootup
  for (int c = 0; c < 512; c++) {
    UPDATE_CRC(oldcrc32, read_prg_byte(0x8000 + c));
    UPDATE_CRC(oldcrc32MMC3, read_prg_byte(0xE000 + c));
  }
  oldcrc32 = ~oldcrc32;
  oldcrc32MMC3 = ~oldcrc32MMC3;
  boolean browseDatabase;

  // Filter out all 0xFF checksums at 0x8000 and 0xE000
  if (oldcrc32 == 0xBD7BC39F && oldcrc32MMC3 == 0xBD7BC39F) {
    println_Msg(F("No data found."));
    println_Msg(F("Using manual selection"));
    display_Update();
    delay(1000);
    setDefaultRomName();
    browseDatabase = selectMapping(database);
  } else {
    println_Msg(F("Searching database"));
    print_Msg(F("for "));
    sprintf(crcStr, "%08lX", oldcrc32);
    print_Msg(crcStr);
    if (oldcrc32 != oldcrc32MMC3) {
      char crcStrMMC3[9];
      print_Msg(F(" or "));
      sprintf(crcStrMMC3, "%08lX", oldcrc32MMC3);
      print_Msg(crcStrMMC3);
    }
    println_Msg(F("..."));
    display_Update();
    while (database.available()) {
      struct database_entry entry;

      readDatabaseEntry(database, &entry);
      //if checksum search was successful set mapper and end search, also filter out 0xFF checksum
      if (
        entry.crc512 != 0xBD7BC39F && (entry.crc512 == oldcrc32 || entry.crc512 == oldcrc32MMC3)) {
        // Rewind to start of entry
        rewind_line(database, 3);
        break;
      }
    }
    if (database.available()) {
      browseDatabase = true;
    } else {
      // File searched until end but nothing found
      println_Msg(F(""));
      println_Msg(F("CRC not found in database"));
      println_Msg(F("Using manual selection"));
      display_Update();
      delay(500);
      // Print debug
      printPRG(0x8000);
      printPRG(0xE000);

      // Change ROM name to CART
      setDefaultRomName();
      browseDatabase = selectMapping(database);
    }
  }
  if (browseDatabase) {
    byte fastScrolling = 1;

    // Display database
    while (database.available()) {
      byte iNES[16];
      byte* output;
      char* input;

      struct database_entry entry;

      display_Clear();
      readDatabaseEntry(database, &entry);

      input = entry.iNES_str;
      output = iNES;
      for (byte i = 0; i < sizeof(iNES); i++) {
        unsigned int buf;

        sscanf(input, "%2X", &buf);
        *(output++) = buf;
        input += 2;
      }

      mapper = (iNES[6] >> 4) | (iNES[7] & 0xF0) | (iNES[8] & 0x0F);

      if ((iNES[9] & 0x0F) != 0x0F) {
        // simple notation
        prgsize = (iNES[4] | ((iNES[9] & 0x0F) << 8));  //*16
      } else {
        // exponent-multiplier notation
        prgsize = (((1 << (iNES[4] >> 2)) * ((iNES[4] & 0b11) * 2 + 1)) >> 14);  //*16
      }
      if (prgsize != 0)
        prgsize = (int(log(prgsize) / log(2)));

      if ((iNES[9] & 0xF0) != 0xF0) {
        // simple notation
        chrsize = (uppow2(iNES[5] | ((iNES[9] & 0xF0) << 4))) * 2;  //*4
      } else {
        // exponent-multiplier notation
        chrsize = (((1 << (iNES[5] >> 2)) * ((iNES[5] & 0b11) * 2 + 1)) >> 13) * 2;  //*4
      }
      if (chrsize != 0)
        chrsize = (int(log(chrsize) / log(2)));

      ramsize = ((iNES[10] & 0xF0) ? (64 << ((iNES[10] & 0xF0) >> 4)) : 0) / 4096;  //*4
      if (ramsize != 0)
        ramsize = (int(log(ramsize) / log(2)));

      prg = (int_pow(2, prgsize)) * 16;
      if (chrsize == 0)
        chr = 0;  // 0K
      else
        chr = (int_pow(2, chrsize)) * 4;
      if (ramsize == 0)
        ram = 0;  // 0K
      else if (mapper == 82)
        ram = 5;  // 5K
      else
        ram = (int_pow(2, ramsize)) * 4;

      // Mapper Variants
      // Identify variant for use across multiple functions
      if (mapper == 4) {  // Check for MMC6/MMC3
        checkMMC6();
        if (mmc6)
          ram = 1;  // 1K
      }

#ifdef global_log
      // Disable log to prevent unnecessary logging
      //println_Log(F("Get Mapping from List"));
      dont_log = true;
#endif
      println_Msg(entry.filename);
      printNESSettings();
#if defined(enable_OLED)
      print_STR(press_to_change_STR, 0);
      if (fastScrolling > 1)
        println_Msg(F(" (fast)"));
      else
        println_Msg("");
      print_STR(right_to_select_STR, 1);
#elif defined(enable_LCD)
      print_STR(rotate_to_change_STR, 0);
      if (fastScrolling > 1)
        println_Msg(F(" (fast)"));
      else
        println_Msg("");
      print_STR(press_to_select_STR, 1);
#elif defined(SERIAL_MONITOR)
      println_Msg(F("U/D to Change"));
      println_Msg(F("Space to Select"));
#endif
      display_Update();

#ifdef global_log
      // Enable log again
      dont_log = false;
#endif
      int b = 0;
      do {
        b = checkButton();
      } while (b == 0);

      if (b == 1) {
        // 1: Next record
        if (fastScrolling > 1) {
          for (byte skipped = 0; skipped < fastScrolling * 3; skipped++) {
            skip_line(&database);
          }
        }
        continue;
      }
      if (b == 2) {
        // 2: Previous record
        if (fastScrolling > 1)
          rewind_line(database, fastScrolling * 3 + 3);
        else
          rewind_line(database, 6);
        continue;
      }
      if (b == 4) {
        // 4: Toggle Fast Scrolling
        if (fastScrolling == 1)
          fastScrolling = 30;
        else
          fastScrolling = 1;
        continue;
      }
      // anything else: select current record
      setRomnameFromString(entry.filename);
      // Save Mapper
      EEPROM_writeAnything(7, mapper);
      EEPROM_writeAnything(8, prgsize);
      EEPROM_writeAnything(9, chrsize);
      EEPROM_writeAnything(10, ramsize);
      break;
    }
  }
  database.close();
}

static void readDatabaseEntry(FsFile& database, struct database_entry* entry) {
  get_line(entry->filename, &database, sizeof(entry->filename));
  get_line(entry->crc_str, &database, sizeof(entry->crc_str));
  skip_line(&database);

  entry->crc_str[8] = 0;
  entry->crc512_str = &entry->crc_str[8 + 1];
  entry->crc512_str[8] = 0;
  entry->iNES_str = &entry->crc_str[8 + 1 + 8 + 1];
  memcpy(iNES_HEADER, entry->iNES_str, sizeof(iNES_HEADER));

  entry->crc = strtoul(entry->crc_str, NULL, 16);
  entry->crc512 = strtoul(entry->crc512_str, NULL, 16);
}

boolean selectMapping(FsFile& database) {
  // Select starting letter
  byte myLetter = starting_letter();

  if (myLetter == 27) {
    // Change Mapper
    setMapper();
    checkMapperSize();
    setPRGSize();
    setCHRSize();
    setRAMSize();
    return 0;
  } else {
#ifdef global_log
    // Disable log to prevent unnecessary logging
    println_Log(F("Select Mapping from List"));
    dont_log = true;
#endif
    database.rewind();
    // Skip ahead to selected starting letter
    if ((myLetter > 0) && (myLetter <= 26)) {
      myLetter += 'A' - 1;
      struct database_entry entry;
      // Read current name
      do {
        readDatabaseEntry(database, &entry);
      } while (database.available() && entry.filename[0] != myLetter);
      rewind_line(database, 3);
    }
#ifdef global_log
    // Enable log again
    dont_log = false;
#endif
  }
  return 1;
}

void readRom_NES() {
  // Get name, add extension and convert to char array for sd lib
  strcpy(fileName, romName);
  strcat(fileName, ".nes");

  // create a new folder
  EEPROM_readAnything(0, foldern);
  sprintf(folder, "NES/ROM/%s/%d", romName, foldern);
  sd.mkdir(folder, true);
  sd.chdir(folder);

  display_Clear();
  print_STR(saving_to_STR, 0);
  print_Msg(folder);
  println_Msg(F("/..."));
  display_Update();

  // write new folder number back to eeprom
  foldern = foldern + 1;
  EEPROM_writeAnything(0, foldern);

  // Open file on sd card
  if (!myFile.open(fileName, O_RDWR | O_CREAT)) {
    print_FatalError(sd_error_STR);
  }

  //Initialize progress bar
  uint32_t processedProgressBar = 0;
  uint32_t totalProgressBar = (uint32_t)(16 + prgsize * 16 * 1024 + chrsize * 4 * 1024);
  draw_progressbar(0, totalProgressBar);

  //Write iNES header
  myFile.write(iNES_HEADER, 16);

  // update progress bar
  processedProgressBar += 16;
  draw_progressbar(processedProgressBar, totalProgressBar);

  //Write PRG
  readPRG(true);

  // update progress bar
  processedProgressBar += prgsize * 16 * 1024;
  draw_progressbar(processedProgressBar, totalProgressBar);

  //Write CHR
  readCHR(true);

  // update progress bar
  processedProgressBar += chrsize * 4 * 1024;
  draw_progressbar(processedProgressBar, totalProgressBar);

  // Close the file:
  myFile.close();

  // Compare CRC32 with database
  compareCRC("nes.txt", 0, 1, 16);
}

void readRaw_NES() {
  // Get name, add extension and convert to char array for sd lib
  strcpy(fileName, romName);
  strcat(fileName, ".bin");

  // create a new folder
  EEPROM_readAnything(0, foldern);
  sprintf(folder, "NES/ROM/%s/%d", romName, foldern);
  sd.mkdir(folder, true);
  sd.chdir(folder);

  display_Clear();
  print_STR(saving_to_STR, 0);
  print_Msg(folder);
  println_Msg(F("/..."));
  display_Update();

  // write new folder number back to eeprom
  foldern = foldern + 1;
  EEPROM_writeAnything(0, foldern);

  // Open file on sd card
  if (!myFile.open(fileName, O_RDWR | O_CREAT)) {
    print_FatalError(sd_error_STR);
  }

  //Initialize progress bar
  uint32_t processedProgressBar = 0;
  uint32_t totalProgressBar = (uint32_t)(prgsize * 16 * 1024 + chrsize * 4 * 1024);
  draw_progressbar(0, totalProgressBar);

  //Write PRG
  readPRG(true);

  // update progress bar
  processedProgressBar += prgsize * 16 * 1024;
  draw_progressbar(processedProgressBar, totalProgressBar);

  //Write CHR
  readCHR(true);

  // update progress bar
  processedProgressBar += chrsize * 4 * 1024;
  draw_progressbar(processedProgressBar, totalProgressBar);

  // Close the file:
  myFile.close();

  // Compare CRC32 with database
  compareCRC("nes.txt", 0, 0, 0);
}
#endif

/******************************************
   Low Level Functions
 *****************************************/
static void set_address(unsigned int address) {
  unsigned char l = address & 0xFF;
  unsigned char h = address >> 8;
  PORTL = l;
  PORTA = h;

  // PPU /A13
  if ((address >> 13) & 1)
    PORTF &= ~(1 << 4);
  else
    PORTF |= 1 << 4;
}

static void set_romsel(unsigned int address) {
  if (address & 0x8000) {
    ROMSEL_LOW;
  } else {
    ROMSEL_HI;
  }
}

static unsigned char read_prg_byte(unsigned int address) {
  MODE_READ;
  PRG_READ;
  set_address(address);
  PHI2_HI;
  set_romsel(address);
  _delay_us(1);
  return PINK;
}

static unsigned char read_chr_byte(unsigned int address) {
  MODE_READ;
  PHI2_HI;
  ROMSEL_HI;
  set_address(address);
  CHR_READ_LOW;
  _delay_us(1);
  uint8_t result = PINK;
  CHR_READ_HI;
  return result;
}

static void write_prg_byte(unsigned int address, uint8_t data) {
  PHI2_LOW;
  ROMSEL_HI;
  MODE_WRITE;
  PRG_WRITE;
  PORTK = data;

  set_address(address);  // PHI2 low, ROMSEL always HIGH
  //  _delay_us(1);
  PHI2_HI;
  //_delay_us(10);
  set_romsel(address);  // ROMSEL is low if need, PHI2 high
  _delay_us(1);         // WRITING
  //_delay_ms(1); // WRITING
  // PHI2 low, ROMSEL high
  PHI2_LOW;
  _delay_us(1);
  ROMSEL_HI;
  // Back to read mode
  //  _delay_us(1);
  PRG_READ;
  MODE_READ;
  set_address(0);
  // Set phi2 to high state to keep cartridge unreseted
  //  _delay_us(1);
  PHI2_HI;
  //  _delay_us(1);
}

void resetROM() {
  set_address(0);
  PHI2_HI;
  ROMSEL_HI;
}

void write_mmc1_byte(unsigned int address, uint8_t data) {  // write loop for 5 bit register
  if (address >= 0xE000) {
    for (int i = 0; i < 5; i++) {
      write_reg_byte(address, data >> i);  // shift 1 bit into temp register [WRITE RAM SAFE]
    }
  } else {
    for (int j = 0; j < 5; j++) {
      write_prg_byte(address, data >> j);  // shift 1 bit into temp register
    }
  }
}

// REFERENCE FOR REGISTER WRITE TO 0xE000/0xF000
// PORTF 7 = CPU R/W = 0
// PORTF 6 = /IRQ = 1
// PORTF 5 = PPU /RD = 1
// PORTF 4 = PPU /A13 = 1
// PORTF 3 = CIRAM /CE = 1
// PORTF 2 = PPU /WR = 1
// PORTF 1 = /ROMSEL
// PORTF 0 = PHI2 (M2)

// WRITE RAM SAFE TO REGISTERS 0xE000/0xF000
static void write_reg_byte(unsigned int address, uint8_t data) {  // FIX FOR MMC1 RAM CORRUPTION
  PHI2_LOW;
  ROMSEL_HI;  // A15 HI = E000
  MODE_WRITE;
  PRG_WRITE;  // CPU R/W LO
  PORTK = data;

  set_address(address);  // PHI2 low, ROMSEL always HIGH
  // DIRECT PIN TO PREVENT RAM CORRUPTION
  // DIFFERENCE BETWEEN M2 LO AND ROMSEL HI MUST BE AROUND 33ns
  // IF TIME IS GREATER THAN 33ns THEN WRITES TO 0xE000/0xF000 WILL CORRUPT RAM AT 0x6000/0x7000
  PORTF = 0b01111101;  // ROMSEL LO/M2 HI
  PORTF = 0b01111110;  // ROMSEL HI/M2 LO
  _delay_us(1);
  // Back to read mode
  PRG_READ;
  MODE_READ;
  set_address(0);
  // Set phi2 to high state to keep cartridge unreseted
  PHI2_HI;
}

static void write_ram_byte(unsigned int address, uint8_t data) {  // Mapper 19 (Namco 106/163) WRITE RAM SAFE ($E000-$FFFF)
  PHI2_LOW;
  ROMSEL_HI;
  MODE_WRITE;
  PRG_WRITE;
  PORTK = data;

  set_address(address);  // PHI2 low, ROMSEL always HIGH
  PHI2_HI;
  ROMSEL_LOW;    // SET /ROMSEL LOW OTHERWISE CORRUPTS RAM
  _delay_us(1);  // WRITING
  // PHI2 low, ROMSEL high
  PHI2_LOW;
  _delay_us(1);
  ROMSEL_HI;
  // Back to read mode
  PRG_READ;
  MODE_READ;
  set_address(0);
  // Set phi2 to high state to keep cartridge unreseted
  PHI2_HI;
}

static void write_wram_byte(unsigned int address, uint8_t data) {  // Mapper 5 (MMC5) RAM
  PHI2_LOW;
  ROMSEL_HI;
  set_address(address);
  PORTK = data;

  _delay_us(1);
  MODE_WRITE;
  PRG_WRITE;
  PHI2_HI;
  _delay_us(1);  // WRITING
  PHI2_LOW;
  ROMSEL_HI;
  // Back to read mode
  PRG_READ;
  MODE_READ;
  set_address(0);
  // Set phi2 to high state to keep cartridge unreseted
  PHI2_HI;
}

int int_pow(int base, int exp) {  // Power for int
  int result = 1;
  while (exp) {
    if (exp & 1)
      result *= base;
    exp /= 2;
    base *= base;
  }
  return result;
}

/******************************************
   CRC Functions
 *****************************************/

void printCRC(char* checkFile, uint32_t* crcCopy, unsigned long offset) {
  uint32_t crc;
  char tempCRC[9];
  FsFile crcFile = sd.open(checkFile);

  crcFile.seek(offset);
  crc = calculateCRC(crcFile);
  crcFile.close();

  if (crcCopy != NULL) {
    *crcCopy = crc;
  }
  sprintf(tempCRC, "%08lX", crc);
  print_Msg(F("CRC: "));
  println_Msg(tempCRC);
  display_Update();
}

/******************************************
   File Functions
 *****************************************/
void CreateROMFolderInSD() {
  sd.chdir();
  sprintf(folder, "NES/ROM");
  sd.mkdir(folder, true);
  sd.chdir(folder);
}

FsFile createNewFile(const char* prefix, const char* extension) {
  char filename[FILENAME_LENGTH];
  snprintf_P(filename, sizeof(filename), _file_name_no_number_fmt, prefix, extension);
  for (byte i = 0; i < 100; i++) {
    if (!sd.exists(filename)) {
      return sd.open(fileName, O_RDWR | O_CREAT);
    }
    snprintf_P(filename, sizeof(filename), _file_name_with_number_fmt, prefix, i, extension);
  }
  // Could not find an available name, recompose the original name and error out.
  snprintf_P(filename, sizeof(filename), _file_name_no_number_fmt, prefix, extension);

  LED_RED_ON;

  display_Clear();
  print_Msg(filename);
  println_Msg(F(": no available name"));
  display_Update();
  print_FatalError(sd_error_STR);

  LED_RED_OFF;
}

void CreatePRGFileInSD() {
  myFile = createNewFile("PRG", "bin");
}

void CreateCHRFileInSD() {
  myFile = createNewFile("CHR", "bin");
}

void CreateRAMFileInSD() {
  myFile = createNewFile("RAM", "bin");
}

#ifndef nointro
void CartStart() {
  sd.chdir();
  EEPROM_readAnything(0, foldern);  // FOLDER #
  sprintf(folder, "NES/CART/%d", foldern);
  sd.mkdir(folder, true);
  sd.chdir(folder);
}

void CartFinish() {
  foldern += 1;
  EEPROM_writeAnything(0, foldern);  // FOLDER #
  sd.chdir();
}
#endif

/******************************************
   NES 2.0 Header Functions
 *****************************************/
#ifndef nointro
int32_t atoi32_signed(const char* input_string) {
  if (input_string == NULL) {
    return 0;
  }

  int int_sign = 1;
  int i = 0;

  if (input_string[0] == '-') {
    int_sign = -1;
    i = 1;
  }

  int32_t return_val = 0;

  while (input_string[i] != '\0') {
    if (input_string[i] >= '0' && input_string[i] <= '9') {
      return_val = (return_val * 10) + (input_string[i] - '0');
    } else if (input_string[i] != '\0') {
      return 0;
    }

    i++;
  }

  return_val = return_val * int_sign;

  return return_val;
}

uint32_t atoi32_unsigned(const char* input_string) {
  if (input_string == NULL) {
    return 0;
  }

  int i = 0;

  uint32_t return_val = 0;

  while (input_string[i] != '\0') {
    if (input_string[i] >= '0' && input_string[i] <= '9') {
      return_val = (return_val * 10) + (input_string[i] - '0');
    } else if (input_string[i] != '\0') {
      return 0;
    }

    i++;
  }

  return return_val;
}

void outputNES() {
  FsFile nesFile;
  const char fileNES[] = "CART.nes";
  const char fileBIN[] = "CART.bin";
  char* outputFile;
  unsigned long crcOffset = 0;
  uint32_t prg_size_bytes = 1024 * (uint32_t)prg;
  uint32_t chr_size_bytes = 1024 * (uint32_t)chr;
  int has_header = 0;

  display_Clear();

  unsigned char* nes_header_bytes = getNESHeaderForFileInfo(prg_size_bytes, chr_size_bytes, prg_crc32, chr_crc32);

  if (nes_header_bytes != NULL) {
    has_header = 1;
  }

  LED_RED_ON;
  LED_GREEN_ON;
  LED_BLUE_ON;
  if (!myFile.open("PRG.bin", FILE_READ)) {
    LED_GREEN_OFF;
    LED_BLUE_OFF;

    display_Clear();
    println_Msg(F("PRG FILE FAILED!"));
    display_Update();
    print_FatalError(sd_error_STR);
  }

  if (has_header) {
    outputFile = fileNES;
    crcOffset = 16;
  } else {
    outputFile = fileBIN;
  }

  if (!sd.exists(outputFile)) {
    nesFile = sd.open(outputFile, O_RDWR | O_CREAT);
  }
  if (!nesFile) {
    LED_GREEN_OFF;
    LED_BLUE_OFF;

    display_Clear();
    println_Msg(F("NES FILE FAILED!"));
    display_Update();
    print_FatalError(sd_error_STR);
  }

  if (has_header) {
    nesFile.write(nes_header_bytes, 16);
    free(nes_header_bytes);
    display_Clear();
    println_Msg(F("SET HEADER"));
    display_Update();
  }

  size_t n;
  while ((n = myFile.read(sdBuffer, sizeof(sdBuffer))) > 0) {
    nesFile.write(sdBuffer, n);
  }
  myFile.close();
  if (myFile.open("CHR.bin", FILE_READ)) {
    while ((n = myFile.read(sdBuffer, sizeof(sdBuffer))) > 0) {
      nesFile.write(sdBuffer, n);
    }
    myFile.close();
  }
  nesFile.flush();
  nesFile.close();

  display_Clear();
  if (has_header) {
    println_Msg(F("NES FILE OUTPUT!"));
  } else {
    println_Msg(F("BIN FILE OUTPUT!"));
  }
  println_Msg(F(""));
  display_Update();

  printCRC(outputFile, NULL, crcOffset);
  LED_RED_OFF;
  LED_GREEN_OFF;
  LED_BLUE_OFF;
}

unsigned char* getNESHeaderForFileInfo(uint32_t prg_size, uint32_t chr_size, uint32_t prg_crc32, uint32_t chr_crc32) {
  if (prg_size == 0) {
    return NULL;
  }

  char* temp_line;
  unsigned char* nes20_header;
  int i;

  if (!myFile.open("/nes20db.txt", FILE_READ)) {
    return NULL;
  } else {
    display_Clear();
    println_Msg(F("SEARCHING DB"));
    display_Update();
  }

  temp_line = (char*)malloc(256 * sizeof(char));
  while (myFile.available()) {
    // We're reading fixed-length lines
    // padded with null characters
    myFile.read(temp_line, 256);

    uint32_t prg_size_db;
    uint32_t chr_size_db;
    uint32_t prg_crc32_db;
    uint32_t chr_crc32_db;

    // Match PRG and CHR sizes first, then
    // match PRG CRC32 and, if the CHR size
    // is greater than zero, the CHR CRC32
    // as well.
    prg_size_db = getPRGSizeFromDatabaseRow(temp_line);
    if (prg_size == prg_size_db) {
      chr_size_db = getCHRSizeFromDatabaseRow(temp_line);
      if (chr_size == chr_size_db) {
        prg_crc32_db = getPRGCRC32FromDatabaseRow(temp_line);
        if (prg_crc32 == prg_crc32_db) {
          if (chr_size == 0) {
            nes20_header = getNES20HeaderBytesFromDatabaseRow(temp_line);
            free(temp_line);
            myFile.close();
            return nes20_header;
          } else {
            chr_crc32_db = getCHRCRC32FromDatabaseRow(temp_line);
            if (chr_crc32 == chr_crc32_db) {
              nes20_header = getNES20HeaderBytesFromDatabaseRow(temp_line);
              free(temp_line);
              myFile.close();
              return nes20_header;
            }
          }
        }
      }
    }
  }

  free(temp_line);
  myFile.close();
  return NULL;
}

// IMPORTANT: The string returned from this function MUST
// be passed to free() when ready to be disposed of, in
// order to avoid a memory leak.
char* getDatabaseFieldFromRow(const char* dbstr, uint8_t fieldnum) {
  uint8_t field_start_pos = 0;
  uint8_t field_end_pos = 1;
  uint8_t current_field = 0;
  char* return_field;

  // Field order, beginning with field 0:
  // PRG Size, CHR Size, PRG CRC32, CHR CRC32, Game Title, NES 2.0 Header (as ASCII)
  //
  // Each entry is on its own line, with a field delimeter of ^^
  // I'm assuming that nothing will ever use ^^ in a game title, but it's possible
  // that could be wrong, in which case a different field delimeter would need
  // to be used, and the logic here updated.
  if (dbstr == NULL || fieldnum > 5) {
    return NULL;
  }

  if (dbstr[0] == 0 || dbstr[0] == '\n') {
    return NULL;
  }

  for (; field_end_pos < 255 && current_field < fieldnum; field_end_pos++) {
    if (field_start_pos < 254 && dbstr[field_start_pos] == '^' && dbstr[field_start_pos + 1] == '^') {
      current_field++;
      field_start_pos = field_end_pos;
      field_end_pos = field_start_pos + 1;
    }

    if (current_field < fieldnum && dbstr[field_end_pos - 1] == '^' && dbstr[field_end_pos] == '^' || dbstr[field_end_pos] == 0 || dbstr[field_end_pos] == '\n') {
      current_field++;
      field_start_pos = field_end_pos + 1;
      field_end_pos = field_start_pos + 1;
    }
  }

  field_end_pos = field_start_pos;

  while ((dbstr[field_end_pos - 1] != '^' || dbstr[field_end_pos] != '^') && dbstr[field_end_pos] != 0 && dbstr[field_end_pos] != '\n') {
    field_end_pos++;
  }

  if (dbstr[field_end_pos] == '^') {
    field_end_pos = field_end_pos - 2;
  } else {
    field_end_pos = field_end_pos - 1;
  }

  if ((field_end_pos - field_start_pos + 2) == 0) {
    return NULL;
  }

  return_field = (char*)malloc((field_end_pos - field_start_pos + 2) * sizeof(char));

  memcpy(return_field, &dbstr[field_start_pos], field_end_pos - field_start_pos + 1);

  return_field[(field_end_pos - field_start_pos) + 1] = 0;

  return return_field;
}

unsigned char getNibbleFromChar(char num) {
  char ret_char = num & 0x0F;
  if (num > '9') {
    ret_char += 9;
  }

  return ret_char;
}

unsigned char getByteFromChars(char msn, char lsn) {
  unsigned char return_char;
  return_char = (getNibbleFromChar(msn) << 4);
  return_char |= getNibbleFromChar(lsn);

  return return_char;
}

// IMPORTANT: The byte array returned from this function MUST
// be passed to free() when ready to be disposed of, in
// order to avoid a memory leak.
unsigned char* strToBytes(const char* bytestr) {
  uint8_t str_length;
  uint8_t byte_length;
  uint8_t str_idx;
  uint8_t byte_idx = 0;
  unsigned char* byte_arr;

  if (bytestr == NULL) {
    return NULL;
  }

  str_length = (uint8_t)strlen(bytestr);

  if (str_length % 2 != 0) {
    return NULL;
  }

  byte_length = str_length / 2;

  byte_arr = (unsigned char*)malloc(byte_length * sizeof(unsigned char));

  for (str_idx = 0; str_idx < str_length && bytestr[str_idx] != 0; str_idx = str_idx + 2) {
    if (!isxdigit(bytestr[str_idx]) || !isxdigit(bytestr[str_idx + 1])) {
      free(byte_arr);
      return NULL;
    }

    byte_arr[byte_idx] = getByteFromChars(bytestr[str_idx], bytestr[str_idx + 1]);
    byte_idx++;
  }

  return byte_arr;
}

uint32_t crc32FromBytes(const unsigned char* bytearr) {
  if (bytearr == NULL) {
    return 0;
  }

  return (uint32_t)(((uint32_t)bytearr[0] << 24) | ((uint32_t)bytearr[1] << 16) | ((uint32_t)bytearr[2] << 8) | (uint32_t)bytearr[3]);
}

uint32_t getPRGSizeFromDatabaseRow(const char* crctest) {
  char* prg_size_str = getDatabaseFieldFromRow(crctest, 0);
  if (prg_size_str == NULL) {
    return 0;
  }

  uint32_t return_size = atoi32_unsigned(prg_size_str);
  free(prg_size_str);

  return return_size;
}

uint32_t getCHRSizeFromDatabaseRow(const char* crctest) {
  char* chr_size_str = getDatabaseFieldFromRow(crctest, 1);
  if (chr_size_str == NULL) {
    return 0;
  }

  uint32_t return_size = atoi32_unsigned(chr_size_str);
  free(chr_size_str);

  return return_size;
}

uint32_t getPRGCRC32FromDatabaseRow(const char* crctest) {
  char* prg_crc32_str = getDatabaseFieldFromRow(crctest, 2);
  if (prg_crc32_str == NULL) {
    return 0;
  }

  unsigned char* prg_crc32_bytes = strToBytes(prg_crc32_str);
  free(prg_crc32_str);

  if (prg_crc32_bytes == NULL) {
    return 0;
  }

  uint32_t prg_crc32 = crc32FromBytes(prg_crc32_bytes);
  free(prg_crc32_bytes);

  return prg_crc32;
}

uint64_t getCHRCRC32FromDatabaseRow(const char* crctest) {
  char* chr_crc32_str = getDatabaseFieldFromRow(crctest, 3);
  if (chr_crc32_str == NULL) {
    return 0;
  }

  unsigned char* chr_crc32_bytes = strToBytes(chr_crc32_str);
  free(chr_crc32_str);

  if (chr_crc32_bytes == NULL) {
    return 0;
  }

  uint32_t chr_crc32 = crc32FromBytes(chr_crc32_bytes);
  free(chr_crc32_bytes);

  return chr_crc32;
}

// IMPORTANT: As with getDatabaseFieldFromRow(), the string
// returned from this function must be passed to free() after
// it's no longer needed in order to avoid a memory leak.
char* getGameTitleFromDatabaseRow(const char* crctest) {
  char* game_title_str = getDatabaseFieldFromRow(crctest, 4);

  return game_title_str;
}

// IMPORTANT: The byte array returned from this function MUST
// be passed to free() when ready to be disposed of, in
// order to avoid a memory leak.
unsigned char* getNES20HeaderBytesFromDatabaseRow(const char* crctest) {
  char* nes_header_str = getDatabaseFieldFromRow(crctest, 5);
  if (nes_header_str == NULL) {
    return NULL;
  }

  unsigned char* nes_header_bytes = strToBytes(nes_header_str);
  free(nes_header_str);

  if (nes_header_bytes == NULL) {
    return NULL;
  }

  return nes_header_bytes;
}
#endif

/******************************************
   Config Functions
 *****************************************/
void setMapper() {
  byte newmapper;
#ifdef global_log
  // Disable log to prevent unnecessary logging
  println_Log(F("Set Mapper manually"));
  dont_log = true;
#endif

  // OLED
#if defined(enable_OLED)
chooseMapper:
  // Read stored mapper
  EEPROM_readAnything(7, newmapper);
  if (newmapper > 220)
    newmapper = 0;
  // Split into digits
  byte hundreds = newmapper / 100;
  byte tens = newmapper / 10 - hundreds * 10;
  byte units = newmapper - hundreds * 100 - tens * 10;

  // Cycle through all 3 digits
  byte digit = 0;
  while (digit < 3) {
    display_Clear();
    println_Msg(F("Select Mapper:"));
    display.setCursor(23, 20);
    println_Msg(hundreds);
    display.setCursor(43, 20);
    println_Msg(tens);
    display.setCursor(63, 20);
    println_Msg(units);
    println_Msg("");
    println_Msg("");
    println_Msg("");
    print_STR(press_to_change_STR, 1);
    println_Msg(F("Press right to select"));

    if (digit == 0) {
      display.setDrawColor(1);
      display.drawLine(20, 30, 30, 30);
      display.setDrawColor(0);
      display.drawLine(40, 30, 50, 30);
      display.drawLine(60, 30, 70, 30);
      display.setDrawColor(1);
    } else if (digit == 1) {
      display.setDrawColor(0);
      display.drawLine(20, 30, 30, 30);
      display.setDrawColor(1);
      display.drawLine(40, 30, 50, 30);
      display.setDrawColor(0);
      display.drawLine(60, 30, 70, 30);
      display.setDrawColor(1);
    } else if (digit == 2) {
      display.setDrawColor(0);
      display.drawLine(20, 30, 30, 30);
      display.drawLine(40, 30, 50, 30);
      display.setDrawColor(1);
      display.drawLine(60, 30, 70, 30);
    }
    display.updateDisplay();

    while (1) {
      /* Check Button
         1 click
         2 doubleClick
         3 hold
         4 longHold */
      int b = checkButton();

      if (b == 1) {
        if (digit == 0) {
          if (hundreds < 2)
            hundreds++;
          else
            hundreds = 0;
        } else if (digit == 1) {
          if (hundreds == 2) {
            if (tens < 1)
              tens++;
            else
              tens = 0;
          } else {
            if (tens < 9)
              tens++;
            else
              tens = 0;
          }
        } else if (digit == 2) {
          if (units < 9)
            units++;
          else
            units = 0;
        }
        break;
      } else if (b == 2) {
        if (digit == 0) {
          if (hundreds > 0)
            hundreds--;
          else
            hundreds = 2;
        } else if (digit == 1) {
          if (hundreds == 2) {
            if (tens > 0)
              tens--;
            else
              tens = 1;
          } else {
            if (tens > 0)
              tens--;
            else
              tens = 9;
          }
        } else if (digit == 2) {
          if (units > 0)
            units--;
          else
            units = 9;
        }
        break;
      } else if (b == 3) {
        digit++;
        break;
      }
    }
  }
  display_Clear();

  newmapper = hundreds * 100 + tens * 10 + units;

  // Check if valid
  boolean validMapper = 0;
  byte mapcount = (sizeof(mapsize) / sizeof(mapsize[0])) / 7;
  for (byte currMaplist = 0; currMaplist < mapcount; currMaplist++) {
    if (pgm_read_byte(mapsize + currMaplist * 7) == newmapper)
      validMapper = 1;
  }

  if (!validMapper) {
    errorLvl = 1;
    display.println(F("Mapper not supported"));
    display.updateDisplay();
    wait();
    goto chooseMapper;
  }

  // LCD
#elif defined(enable_LCD)
  int i = 0;

  display_Clear();
  mapselect = pgm_read_byte(mapsize + i * 7);
  print_Msg(F("Mapper: "));
  println_Msg(mapselect);
  println_Msg(F(""));
  print_STR(rotate_to_change_STR, 1);
  print_STR(press_to_select_STR, 1);
  display_Update();

  while (1) {
    int b = checkButton();

    if (b == 2) {  // Previous Mapper
      if (i == 0)
        i = mapcount - 1;
      else
        i--;

      display_Clear();
      mapselect = pgm_read_byte(mapsize + i * 7);
      print_Msg(F("Mapper: "));
      println_Msg(mapselect);
      println_Msg(F(""));
      print_STR(rotate_to_change_STR, 1);
      print_STR(press_to_select_STR, 1);
      display_Update();
    }

    else if (b == 1) {  // Next Mapper
      if (i == (mapcount - 1))
        i = 0;
      else
        i++;

      display_Clear();
      mapselect = pgm_read_byte(mapsize + i * 7);
      print_Msg(F("Mapper: "));
      println_Msg(mapselect);
      println_Msg(F(""));
      print_STR(rotate_to_change_STR, 1);
      print_STR(press_to_select_STR, 1);
      display_Update();
    }

    else if (b == 3) {  // Long Press - Execute
      newmapper = mapselect;
      break;
    }
  }

  display.setCursor(0, 56 + 8);
  print_Msg(F("MAPPER "));
  print_Msg(newmapper);
  println_Msg(F(" SELECTED"));
  display_Update();
  delay(1000);

  // Serial Monitor
#elif defined(enable_serial)
setmapper:
  String newmap;
  boolean mapfound = false;
  Serial.println(F("SUPPORTED MAPPERS:"));
  for (int i = 0; i < mapcount; i++) {
    int index = i * 7;
    mapselect = pgm_read_byte(mapsize + index);
    Serial.print("[");
    Serial.print(mapselect);
    Serial.print("]");
    if (i < mapcount - 1) {
      if ((i != 0) && ((i + 1) % 10 == 0))
        Serial.println(F(""));
      else
        Serial.print(F("\t"));
    } else
      Serial.println(F(""));
  }
  Serial.print(F("Enter Mapper: "));
  while (Serial.available() == 0) {}
  newmap = Serial.readStringUntil('\n');
  Serial.println(newmap);
  newmapper = newmap.toInt();
  for (int i = 0; i < mapcount; i++) {
    int index = i * 7;
    mapselect = pgm_read_byte(mapsize + index);
    if (newmapper == mapselect)
      mapfound = true;
  }
  if (mapfound == false) {
    Serial.println(F("MAPPER NOT SUPPORTED!"));
    Serial.println(F(""));
    newmapper = 0;
    goto setmapper;
  }
#endif

  EEPROM_writeAnything(7, newmapper);
  mapper = newmapper;

#ifdef global_log
  // Enable log again
  dont_log = false;
#endif
}

void checkMapperSize() {
  for (int i = 0; i < mapcount; i++) {
    int index = i * 7;
    byte mapcheck = pgm_read_byte(mapsize + index);
    if (mapcheck == mapper) {
      prglo = pgm_read_byte(mapsize + index + 1);
      prghi = pgm_read_byte(mapsize + index + 2);
      chrlo = pgm_read_byte(mapsize + index + 3);
      chrhi = pgm_read_byte(mapsize + index + 4);
      ramlo = pgm_read_byte(mapsize + index + 5);
      ramhi = pgm_read_byte(mapsize + index + 6);
      break;
    }
  }
}

void setPRGSize() {
#ifdef global_log
  // Disable log to prevent unnecessary logging
  println_Log(F("Set PRG Size"));
  dont_log = true;
#endif

#if (defined(enable_LCD) || defined(enable_OLED))
  display_Clear();
  if (prglo == prghi)
    newprgsize = prglo;
  else {
    int i = prglo;

    display_Clear();
    print_Msg(F("PRG Size: "));
    println_Msg(pgm_read_word(&(PRG[i])));
    println_Msg(F(""));
#if defined(enable_OLED)
    print_STR(press_to_change_STR, 1);
    println_Msg(F("Press right to select"));
#elif defined(enable_LCD)
    print_STR(rotate_to_change_STR, 1);
    print_STR(press_to_select_STR, 1);
#endif
    display_Update();

    while (1) {
      int b = checkButton();

      if (b == doubleclick) {  // Previous
        if (i == prglo)
          i = prghi;
        else
          i--;

        display_Clear();
        print_Msg(F("PRG Size: "));
        println_Msg(pgm_read_word(&(PRG[i])));
        println_Msg(F(""));
#if defined(enable_OLED)
        print_STR(press_to_change_STR, 1);
        println_Msg(F("Press right to select"));
#elif defined(enable_LCD)
        print_STR(rotate_to_change_STR, 1);
        print_STR(press_to_select_STR, 1);
#endif
        display_Update();
      }
      if (b == press) {  // Next
        if (i == prghi)
          i = prglo;
        else
          i++;

        display_Clear();
        print_Msg(F("PRG Size: "));
        println_Msg(pgm_read_word(&(PRG[i])));
        println_Msg(F(""));
#if defined(enable_OLED)
        print_STR(press_to_change_STR, 1);
        println_Msg(F("Press right to select"));
#elif defined(enable_LCD)
        print_STR(rotate_to_change_STR, 1);
        print_STR(press_to_select_STR, 1);
#endif
        display_Update();
      }
      if (b == hold) {  // Long Press - Execute
        newprgsize = i;
        break;
      }
    }

    display.setCursor(0, 56);  // Display selection at bottom
  }
  print_Msg(F("PRG SIZE "));
  print_Msg(pgm_read_word(&(PRG[newprgsize])));
  println_Msg(F("K"));
  display_Update();
  delay(1000);

#elif defined(enable_serial)
  if (prglo == prghi)
    newprgsize = prglo;
  else {
setprg:
    String sizePRG;
    for (int i = 0; i < (prghi - prglo + 1); i++) {
      Serial.print(F("Select PRG Size:  "));
      Serial.print(i);
      Serial.print(F(" = "));
      Serial.print(pgm_read_word(&(PRG[i + prglo])));
      Serial.println(F("K"));
    }
    Serial.print(F("Enter PRG Size: "));
    while (Serial.available() == 0) {}
    sizePRG = Serial.readStringUntil('\n');
    Serial.println(sizePRG);
    newprgsize = sizePRG.toInt() + prglo;
    if (newprgsize > prghi) {
      Serial.println(F("SIZE NOT SUPPORTED"));
      Serial.println(F(""));
      goto setprg;
    }
  }
  Serial.print(F("PRG Size = "));
  Serial.print(pgm_read_word(&(PRG[newprgsize])));
  Serial.println(F("K"));
#endif
  EEPROM_writeAnything(8, newprgsize);
  prgsize = newprgsize;

#ifdef global_log
  // Enable log again
  dont_log = false;
#endif
}

void setCHRSize() {
#ifdef global_log
  // Disable log to prevent unnecessary logging
  println_Log(F("Set CHR Size"));
  dont_log = true;
#endif

#if (defined(enable_LCD) || defined(enable_OLED))
  display_Clear();
  if (chrlo == chrhi)
    newchrsize = chrlo;
  else {
    int i = chrlo;

    display_Clear();
    print_Msg(F("CHR Size: "));
    println_Msg(pgm_read_word(&(CHR[i])));
    println_Msg(F(""));
#if defined(enable_OLED)
    print_STR(press_to_change_STR, 1);
    println_Msg(F("Press right to select"));
#elif defined(enable_LCD)
    print_STR(rotate_to_change_STR, 1);
    print_STR(press_to_select_STR, 1);
#endif
    display_Update();

    while (1) {
      int b = checkButton();

      if (b == doubleclick) {  // Previous
        if (i == chrlo)
          i = chrhi;
        else
          i--;

        display_Clear();
        print_Msg(F("CHR Size: "));
        println_Msg(pgm_read_word(&(CHR[i])));
        println_Msg(F(""));
#if defined(enable_OLED)
        print_STR(press_to_change_STR, 1);
        println_Msg(F("Press right to select"));
#elif defined(enable_LCD)
        print_STR(rotate_to_change_STR, 1);
        print_STR(press_to_select_STR, 1);
#endif
        display_Update();
      }

      if (b == press) {  // Next
        if (i == chrhi)
          i = chrlo;
        else
          i++;

        display_Clear();
        print_Msg(F("CHR Size: "));
        println_Msg(pgm_read_word(&(CHR[i])));
        println_Msg(F(""));
#if defined(enable_OLED)
        print_STR(press_to_change_STR, 1);
        println_Msg(F("Press right to select"));
#elif defined(enable_LCD)
        print_STR(rotate_to_change_STR, 1);
        print_STR(press_to_select_STR, 1);
#endif
        display_Update();
      }

      if (b == hold) {  // Long Press - Execute
        newchrsize = i;
        break;
      }
    }
    display.setCursor(0, 56);  // Display selection at bottom
  }
  print_Msg(F("CHR SIZE "));
  print_Msg(pgm_read_word(&(CHR[newchrsize])));
  println_Msg(F("K"));
  display_Update();
  delay(1000);

#elif defined(enable_serial)
  if (chrlo == chrhi)
    newchrsize = chrlo;
  else {
setchr:
    String sizeCHR;
    for (int i = 0; i < (chrhi - chrlo + 1); i++) {
      Serial.print(F("Select CHR Size:  "));
      Serial.print(i);
      Serial.print(F(" = "));
      Serial.print(pgm_read_word(&(CHR[i + chrlo])));
      Serial.println(F("K"));
    }
    Serial.print(F("Enter CHR Size: "));
    while (Serial.available() == 0) {}
    sizeCHR = Serial.readStringUntil('\n');
    Serial.println(sizeCHR);
    newchrsize = sizeCHR.toInt() + chrlo;
    if (newchrsize > chrhi) {
      Serial.println(F("SIZE NOT SUPPORTED"));
      Serial.println(F(""));
      goto setchr;
    }
  }
  Serial.print(F("CHR Size = "));
  Serial.print(pgm_read_word(&(CHR[newchrsize])));
  Serial.println(F("K"));
#endif
  EEPROM_writeAnything(9, newchrsize);
  chrsize = newchrsize;

#ifdef global_log
  // Enable log again
  dont_log = false;
#endif
}

void setRAMSize() {
#ifdef global_log
  // Disable log to prevent unnecessary logging
  println_Log(F("Set RAM Size"));
  dont_log = true;
#endif

#if (defined(enable_LCD) || defined(enable_OLED))
  display_Clear();
  if (ramlo == ramhi)
    newramsize = ramlo;
  else {
    int i = 0;

    display_Clear();
    print_Msg(F("RAM Size: "));
    if (mapper == 0)
      println_Msg(pgm_read_byte(&(RAM[i])) / 4);
    else if (mapper == 16)
      println_Msg(pgm_read_byte(&(RAM[i])) * 32);
    else if (mapper == 19) {
      if (i == 2)
        println_Msg(F("128"));
      else
        println_Msg(pgm_read_byte(&(RAM[i])));
    } else if ((mapper == 159) || (mapper == 80))
      println_Msg(pgm_read_byte(&(RAM[i])) * 16);
    else if (mapper == 82)
      println_Msg(i * 5);
    else
      println_Msg(pgm_read_byte(&(RAM[i])));
    println_Msg(F(""));
#if defined(enable_OLED)
    print_STR(press_to_change_STR, 1);
    println_Msg(F("Press right to select"));
#elif defined(enable_LCD)
    print_STR(rotate_to_change_STR, 1);
    print_STR(press_to_select_STR, 1);
#endif
    display_Update();

    while (1) {
      int b = checkButton();

      if (b == doubleclick) {  // Previous Mapper
        if (i == 0)
          i = ramhi;
        else
          i--;

        display_Clear();
        print_Msg(F("RAM Size: "));
        if (mapper == 0)
          println_Msg(pgm_read_byte(&(RAM[i])) / 4);
        else if (mapper == 16)
          println_Msg(pgm_read_byte(&(RAM[i])) * 32);
        else if (mapper == 19) {
          if (i == 2)
            println_Msg(F("128"));
          else
            println_Msg(pgm_read_byte(&(RAM[i])));
        } else if ((mapper == 159) || (mapper == 80))
          println_Msg(pgm_read_byte(&(RAM[i])) * 16);
        else if (mapper == 82)
          println_Msg(i * 5);
        else
          println_Msg(pgm_read_byte(&(RAM[i])));
        println_Msg(F(""));
#if defined(enable_OLED)
        print_STR(press_to_change_STR, 1);
        println_Msg(F("Press right to select"));
#elif defined(enable_LCD)
        print_STR(rotate_to_change_STR, 1);
        print_STR(press_to_select_STR, 1);
#endif
        display_Update();
      }

      if (b == press) {  // Next
        if (i == ramhi)
          i = 0;
        else
          i++;

        display_Clear();
        print_Msg(F("RAM Size: "));
        if (mapper == 0)
          println_Msg(pgm_read_byte(&(RAM[i])) / 4);
        else if (mapper == 16)
          println_Msg(pgm_read_byte(&(RAM[i])) * 32);
        else if (mapper == 19) {
          if (i == 2)
            println_Msg(F("128"));
          else
            println_Msg(pgm_read_byte(&(RAM[i])));
        } else if ((mapper == 159) || (mapper == 80))
          println_Msg(pgm_read_byte(&(RAM[i])) * 16);
        else if (mapper == 82)
          println_Msg(i * 5);
        else
          println_Msg(pgm_read_byte(&(RAM[i])));
        println_Msg(F(""));
#if defined(enable_OLED)
        print_STR(press_to_change_STR, 1);
        println_Msg(F("Press right to select"));
#elif defined(enable_LCD)
        print_STR(rotate_to_change_STR, 1);
        print_STR(press_to_select_STR, 1);
#endif
        display_Update();
      }

      if (b == hold) {  // Long Press - Execute
        newramsize = i;
        break;
      }
    }

    display.setCursor(0, 56);  // Display selection at bottom
  }
  if ((mapper == 16) || (mapper == 159)) {
    int sizeEEP = 0;
    print_Msg(F("EEPROM SIZE "));
    if (mapper == 16)
      sizeEEP = pgm_read_byte(&(RAM[newramsize])) * 32;
    else
      sizeEEP = pgm_read_byte(&(RAM[newramsize])) * 16;
    print_Msg(sizeEEP);
    println_Msg(F("B"));
  } else if (mapper == 19) {
    print_Msg(F("RAM SIZE "));
    if (newramsize == 2)
      println_Msg(F("128B"));
    else {
      print_Msg(pgm_read_byte(&(RAM[newramsize])));
      println_Msg(F("K"));
    }
  } else if (mapper == 80) {
    print_Msg(F("RAM SIZE "));
    print_Msg(pgm_read_byte(&(RAM[newramsize])) * 16);
    println_Msg(F("B"));
  } else {
    print_Msg(F("RAM SIZE "));
    if (mapper == 0)
      print_Msg(newramsize * 2);
    else if (mapper == 82)
      print_Msg(newramsize * 5);
    else
      print_Msg(pgm_read_byte(&(RAM[newramsize])));
    println_Msg(F("K"));
  }
  display_Update();
  delay(1000);

#elif defined(enable_serial)
  if (ramlo == ramhi)
    newramsize = ramlo;
  else {
setram:
    String sizeRAM;
    for (int i = 0; i < (ramhi - ramlo + 1); i++) {
      Serial.print(F("Select RAM Size:  "));
      Serial.print(i);
      Serial.print(F(" = "));
      if (mapper == 0) {
        Serial.print(pgm_read_byte(&(RAM[i])) / 4);
        Serial.println(F("K"));
      } else if ((mapper == 16) || (mapper == 159)) {
        if (mapper == 16)
          Serial.print(pgm_read_byte(&(RAM[i + ramlo])) * 32);
        else
          Serial.print(pgm_read_byte(&(RAM[i + ramlo])) * 16);
        Serial.println(F("B"));
      } else if (mapper == 19) {
        if (i == 2)
          Serial.println(F("128B"));
        else {
          Serial.print(pgm_read_byte(&(RAM[i + ramlo])));
          Serial.println(F("K"));
        }
      } else {
        Serial.print(pgm_read_byte(&(RAM[i + ramlo])));
        Serial.println(F("K"));
      }
    }
    Serial.print(F("Enter RAM Size: "));
    while (Serial.available() == 0) {}
    sizeRAM = Serial.readStringUntil('\n');
    Serial.println(sizeRAM);
    newramsize = sizeRAM.toInt() + ramlo;
    if (newramsize > ramhi) {
      Serial.println(F("SIZE NOT SUPPORTED"));
      Serial.println(F(""));
      goto setram;
    }
  }
  if ((mapper == 16) || (mapper == 159)) {
    int sizeEEP = 0;
    Serial.print(F("EEPROM Size = "));
    if (mapper == 16)
      sizeEEP = pgm_read_byte(&(RAM[newramsize])) * 32;
    else
      sizeEEP = pgm_read_byte(&(RAM[newramsize])) * 16;
    Serial.print(sizeEEP);
    Serial.println(F("B"));
    Serial.println(F(""));
  } else if (mapper == 19) {
    Serial.print(F("RAM Size =  "));
    if (newramsize == 2)
      Serial.println(F("128B"));
    else {
      Serial.print(pgm_read_byte(&(RAM[newramsize])));
      Serial.println(F("K"));
    }
    Serial.println(F(""));
  } else if (mapper == 80) {
    Serial.print(F("RAM Size = "));
    Serial.print(pgm_read_byte(&(RAM[newramsize])) * 16);
    Serial.println(F("B"));
    Serial.println(F(""));
  } else {
    Serial.print(F("RAM Size = "));
    if (mapper == 0)
      Serial.print(newramsize * 2);
    else if (mapper == 82)
      Serial.print(newramsize * 5);
    else
      Serial.print(pgm_read_byte(&(RAM[newramsize])));
    Serial.println(F("K"));
    Serial.println(F(""));
  }
#endif
  EEPROM_writeAnything(10, newramsize);
  ramsize = newramsize;

#ifdef global_log
  // Enable log again
  dont_log = false;
#endif
}

// MMC6 Detection
// Mapper 4 includes both MMC3 AND MMC6
// RAM is mapped differently between MMC3 and MMC6
void checkMMC6() {               // Detect MMC6 Carts - read PRG 0x3E00A ("STARTROPICS")
  write_prg_byte(0x8000, 6);     // PRG Bank 0 ($8000-$9FFF)
  write_prg_byte(0x8001, 0x1F);  // 0x3E000
  prgchk0 = read_prg_byte(0x800A);
  prgchk1 = read_prg_byte(0x800B);
  prgchk2 = read_prg_byte(0x800C);
  prgchk3 = read_prg_byte(0x800D);
  if ((prgchk0 == 0x53) && (prgchk1 == 0x54) && (prgchk2 == 0x41) && (prgchk3 == 0x52))
    mmc6 = true;  // MMC6 Cart
}

void checkStatus_NES() {
  EEPROM_readAnything(7, mapper);
  EEPROM_readAnything(8, prgsize);
  EEPROM_readAnything(9, chrsize);
  EEPROM_readAnything(10, ramsize);
  prg = (int_pow(2, prgsize)) * 16;
  if (chrsize == 0)
    chr = 0;  // 0K
  else
    chr = (int_pow(2, chrsize)) * 4;
  if (ramsize == 0)
    ram = 0;  // 0K
  else if (mapper == 82)
    ram = 5;  // 5K
  else
    ram = (int_pow(2, ramsize)) * 4;

  // Mapper Variants
  // Identify variant for use across multiple functions
  if (mapper == 4) {  // Check for MMC6/MMC3
    checkMMC6();
    if (mmc6)
      ram = 1;              // 1K
  } else if (mapper == 30)  // Check for Flashable/Non-Flashable
    NESmaker_ID();          // Flash ID

  display_Clear();
  println_Msg(F("NES CART READER"));
  println_Msg(F(""));
  println_Msg(F("CURRENT SETTINGS"));
  println_Msg(F(""));
  printNESSettings();
  println_Msg(F(""));
  // Prints string out of the common strings array either with or without newline
  print_STR(press_button_STR, 1);
  display_Update();
  wait();
}

static void printNESSettings(void) {
  print_Msg(F("MAPPER:   "));
  println_Msg(mapper);
  print_Msg(F("PRG SIZE: "));
  print_Msg(prg);
  println_Msg(F("K"));
  print_Msg(F("CHR SIZE: "));
  print_Msg(chr);
  println_Msg(F("K"));
  print_Msg(F("RAM SIZE: "));
  if (mapper == 0) {
    print_Msg(ram / 4);
    println_Msg(F("K"));
  } else if ((mapper == 16) || (mapper == 80) || (mapper == 159)) {
    if (mapper == 16)
      print_Msg(ram * 32);
    else
      print_Msg(ram * 16);
    println_Msg(F("B"));
  } else if (mapper == 19) {
    if (ramsize == 2)
      println_Msg(F("128B"));
    else {
      print_Msg(ram);
      println_Msg(F("K"));
    }
  } else {
    print_Msg(ram);
    println_Msg(F("K"));
  }
}

/******************************************
   ROM Functions
 *****************************************/
void dumpPRG(word base, word address) {
  for (int x = 0; x < 512; x++) {
    sdBuffer[x] = read_prg_byte(base + address + x);
  }
  myFile.write(sdBuffer, 512);
}

void dumpCHR(word address) {
  for (int x = 0; x < 512; x++) {
    sdBuffer[x] = read_chr_byte(address + x);
  }
  myFile.write(sdBuffer, 512);
}

void dumpCHR_M2(word address) {  // MAPPER 45 - PULSE M2 LO/HI
  for (int x = 0; x < 512; x++) {
    PHI2_LOW;
    sdBuffer[x] = read_chr_byte(address + x);
  }
  myFile.write(sdBuffer, 512);
}

void dumpMMC5RAM(word base, word address) {  // MMC5 SRAM DUMP - PULSE M2 LO/HI
  for (int x = 0; x < 512; x++) {
    PHI2_LOW;
    sdBuffer[x] = read_prg_byte(base + address + x);
  }
  myFile.write(sdBuffer, 512);
}

void writeMMC5RAM(word base, word address) {  // MMC5 SRAM WRITE
  myFile.read(sdBuffer, 512);
  for (int x = 0; x < 512; x++) {
    do {
      write_prg_byte(0x5102, 2);  // PRG RAM PROTECT1
      write_prg_byte(0x5103, 1);  // PRG RAM PROTECT2
      write_wram_byte(base + address + x, sdBuffer[x]);
      bytecheck = read_prg_byte(base + address + x);
    } while (bytecheck != sdBuffer[x]);  // CHECK WRITTEN BYTE
  }
  write_prg_byte(0x5102, 0);  // PRG RAM PROTECT1
  write_prg_byte(0x5103, 0);  // PRG RAM PROTECT2
}

void readPRG(boolean readrom) {
  if (!readrom) {
    display_Clear();
    display_Update();

    LED_BLUE_ON;
    set_address(0);
    _delay_us(1);
    CreatePRGFileInSD();
  } else {
    set_address(0);
    _delay_us(1);
  }

  word base = 0x8000;
  bool busConflict = false;

  if (myFile) {
    switch (mapper) {
      case 0:
      case 3:
      case 13:
      case 87:                                                                                   // 16K/32K
      case 184:                                                                                  // 32K
      case 185:                                                                                  // 16K/32K
        for (word address = 0; address < (((word)prgsize) * 0x4000) + 0x4000; address += 512) {  // 16K or 32K
          dumpPRG(base, address);
        }
        break;

      case 1:
      case 155:  // 32K/64K/128K/256K/512K
        banks = int_pow(2, prgsize) - 1;
        for (int i = 0; i < banks; i++) {   // 16K Banks ($8000-$BFFF)
          write_prg_byte(0x8000, 0x80);     // Clear Register
          write_mmc1_byte(0x8000, 0x0C);    // Switch 16K Bank ($8000-$BFFF) + Fixed Last Bank ($C000-$FFFF)
          if (prgsize > 4)                  // 512K
            write_mmc1_byte(0xA000, 0x00);  // Reset 512K Flag for Lower 256K
          if (i > 15)                       // Switch Upper 256K
            write_mmc1_byte(0xA000, 0x10);  // Set 512K Flag
          write_mmc1_byte(0xE000, i);
          for (word address = 0x0; address < 0x4000; address += 512) {
            dumpPRG(base, address);
          }
        }
        for (word address = 0x4000; address < 0x8000; address += 512) {  // Final Bank ($C000-$FFFF)
          dumpPRG(base, address);
        }
        break;

      case 2:  // bus conflicts - fixed last bank
        banks = int_pow(2, prgsize);
        busConflict = true;
        for (int i = 0; i < banks - 1; i++) {
          for (int x = 0; x < 0x4000; x++) {
            if (read_prg_byte(0xC000 + x) == i) {
              write_prg_byte(0xC000 + x, i);
              busConflict = false;
              break;
            }
          }
          if (busConflict) {
            write_prg_byte(0xC000 + i, i);
          }
          for (word address = 0x0; address < 0x4000; address += 512) {
            dumpPRG(base, address);
          }
        }
        for (word address = 0x4000; address < 0x8000; address += 512) {
          dumpPRG(base, address);
        }
        break;

      case 4:
      case 47:
      case 64:
      case 118:
      case 119:
      case 158:
        banks = ((int_pow(2, prgsize) * 2)) - 2;  // Set Number of Banks
        if (mapper == 47)
          write_prg_byte(0xA001, 0x80);       // Block Register - PRG RAM Chip Enable, Writable
        for (int i = 0; i < banks; i += 2) {  // 32K/64K/128K/256K/512K
          if (mapper == 47) {
            if (i == 0)
              write_prg_byte(0x6000, 0);  // Switch to Lower Block
            else if (i == 16)
              write_prg_byte(0x6000, 1);  // Switch to Upper Block
          }
          write_prg_byte(0x8000, 6);  // PRG Bank 0 ($8000-$9FFF)
          write_prg_byte(0x8001, i);
          write_prg_byte(0x8000, 7);  // PRG Bank 1 ($A000-$BFFF)
          write_prg_byte(0x8001, i + 1);
          for (word address = 0x0; address < 0x4000; address += 512) {
            dumpPRG(base, address);
          }
        }
        if ((mapper == 64) || (mapper == 158)) {
          write_prg_byte(0x8000, 15);  // PRG Bank 2 ($C000-$DFFF)
          write_prg_byte(0x8001, banks);
        }
        for (word address = 0x4000; address < 0x8000; address += 512) {  // Final 2 Banks ($C000-$FFFF)
          dumpPRG(base, address);
        }
        break;

      case 5:  // 128K/256K/512K
        banks = int_pow(2, prgsize) * 2;
        write_prg_byte(0x5100, 3);            // 8K PRG Banks
        for (int i = 0; i < banks; i += 2) {  // 128K/256K/512K
          write_prg_byte(0x5114, i | 0x80);
          write_prg_byte(0x5115, (i + 1) | 0x80);
          for (word address = 0x0; address < 0x4000; address += 512) {
            dumpPRG(base, address);
          }
        }
        break;

      case 7:  // 128K/256K
      case 34:
      case 77:
      case 96:   // 128K
      case 177:  // up to 1024K
      case 241:
        banks = int_pow(2, prgsize) / 2;
        for (int i = 0; i < banks; i++) {  // 32K Banks
          write_prg_byte(0x8000, i);
          for (word address = 0x0; address < 0x8000; address += 512) {  // 32K Banks ($8000-$FFFF)
            dumpPRG(base, address);
          }
        }
        break;

      case 9:                                                           // 128K
        for (int i = 0; i < 13; i++) {                                  // 16-3 = 13 = 128K
          write_prg_byte(0xA000, i);                                    // $8000-$9FFF
          for (word address = 0x0; address < 0x2000; address += 512) {  // Switch Bank ($8000-$9FFF)
            dumpPRG(base, address);
          }
        }
        for (word address = 0x2000; address < 0x8000; address += 512) {  // Final 3 Banks ($A000-$FFFF)
          dumpPRG(base, address);
        }
        break;

      case 10:  // 128K/256K
        for (int i = 0; i < (((prgsize - 3) * 8) + 7); i++) {
          write_prg_byte(0xA000, i);                                    // $8000-$BFFF
          for (word address = 0x0; address < 0x4000; address += 512) {  // Switch Bank ($8000-$BFFF)
            dumpPRG(base, address);
          }
        }
        for (word address = 0x4000; address < 0x8000; address += 512) {  // Final Bank ($C000-$FFFF)
          dumpPRG(base, address);
        }
        break;

      case 11:
        banks = int_pow(2, prgsize) / 2;
        for (int i = 0; i < banks; i++) {
          write_prg_byte(0xFFB0 + i, i);
          for (word address = 0x0; address < 0x8000; address += 512) {
            dumpPRG(base, address);
          }
        }
        break;

      case 15:
        banks = int_pow(2, prgsize);
        for (int i = 0; i < banks; i += 2) {
          write_prg_byte(0x8000, i);
          for (word address = 0x0; address < 0x8000; address += 512) {
            dumpPRG(base, address);
          }
        }
        break;

      case 16:
      case 159:  // 128K/256K
        banks = int_pow(2, prgsize);
        for (int i = 0; i < banks; i++) {
          write_prg_byte(0x6008, i);                                    // Submapper 4
          write_prg_byte(0x8008, i);                                    // Submapper 5
          for (word address = 0x0; address < 0x4000; address += 512) {  // 16K Banks ($8000-$BFFF)
            dumpPRG(base, address);
          }
        }
        break;

      case 18:  // 128K/256K
        banks = int_pow(2, prgsize) * 2;
        for (int i = 0; i < banks; i += 2) {
          write_prg_byte(0x8000, i & 0xF);
          write_prg_byte(0x8001, (i >> 4) & 0xF);
          write_prg_byte(0x8002, (i + 1) & 0xF);
          write_prg_byte(0x8003, ((i + 1) >> 4) & 0xF);
          for (word address = 0x0; address < 0x4000; address += 512) {
            dumpPRG(base, address);
          }
        }
        break;

      case 19:                          // 128K/256K
        for (int j = 0; j < 64; j++) {  // Init Register
          write_ram_byte(0xE000, 0);    // PRG Bank 0 ($8000-$9FFF)
        }
        banks = int_pow(2, prgsize) * 2;
        for (int i = 0; i < banks; i++) {
          write_ram_byte(0xE000, i);  // PRG Bank 0 ($8000-$9FFF)
          for (word address = 0x0; address < 0x2000; address += 512) {
            dumpPRG(base, address);
          }
        }
        break;

      case 21:  // 256K
        banks = int_pow(2, prgsize) * 2;
        for (int i = 0; i < banks; i++) {
          write_prg_byte(0xA000, i);
          for (word address = 0x2000; address < 0x4000; address += 512) {
            dumpPRG(base, address);
          }
        }
        break;

      case 22:
      case 25:
      case 65:
      case 75:  // 128K/256K
        banks = int_pow(2, prgsize) * 2;

        // set vrc4 swap setting for TMNT2
        if (mapper == 25)
          write_prg_byte(0x9005, 0x00);

        for (int i = 0; i < banks; i += 2) {
          write_prg_byte(0x8000, i);
          write_prg_byte(0xA000, i + 1);
          for (word address = 0x0; address < 0x4000; address += 512) {
            dumpPRG(base, address);
          }
        }
        break;

      case 23:
        banks = int_pow(2, prgsize) * 2;
        write_prg_byte(0x9002, 0);
        write_prg_byte(0x9008, 0);
        for (int i = 0; i < banks; i++) {
          write_prg_byte(0x8000, i);
          for (word address = 0x0; address < 0x2000; address += 512) {
            dumpPRG(base, address);
          }
        }
        break;

      case 24:
      case 26:  // 256K
      case 78:  // 128K
        banks = int_pow(2, prgsize);
        for (int i = 0; i < banks; i++) {  // 128K
          write_prg_byte(0x8000, i);
          for (word address = 0x0; address < 0x4000; address += 512) {  // 16K Banks ($8000-$BFFF)
            dumpPRG(base, address);
          }
        }
        break;

      case 28:  // using 32k mode for inner and outer banks, switching only with outer
        banks = int_pow(2, prgsize) / 2;
        write_prg_byte(0x5000, 0x81);
        write_prg_byte(0x8000, 0);
        write_prg_byte(0x5000, 0x80);
        write_prg_byte(0x8000, 0);
        write_prg_byte(0x5000, 0x01);
        write_prg_byte(0x8000, 0);
        write_prg_byte(0x5000, 0x00);
        write_prg_byte(0x8000, 0);
        for (int i = 0; i < banks; i++) {
          write_prg_byte(0x5000, 0x81);
          write_prg_byte(0x8000, i);
          for (word address = 0x0; address < 0x8000; address += 512) {
            dumpPRG(base, address);
          }
        }
        break;

      case 30:  // 256K/512K
        banks = int_pow(2, prgsize);
        for (int i = 0; i < banks; i++) {  // 256K/512K
          if (flashfound)
            write_prg_byte(0xC000 + i, i);  // Flashable
          else
            write_prg_byte(0x8000 + i, i);                              // Non-Flashable
          for (word address = 0x0; address < 0x4000; address += 512) {  // 16K Banks ($8000-$BFFF)
            dumpPRG(base, address);
          }
        }
        break;

      case 31:
        banks = int_pow(2, prgsize) * 4;
        for (int i = 0; i < banks; i += 8) {
          write_prg_byte(0x5FF8, i);
          write_prg_byte(0x5FF9, i + 1);
          write_prg_byte(0x5FFA, i + 2);
          write_prg_byte(0x5FFB, i + 3);
          write_prg_byte(0x5FFC, i + 4);
          write_prg_byte(0x5FFD, i + 5);
          write_prg_byte(0x5FFE, i + 6);
          write_prg_byte(0x5FFF, i + 7);
          for (word address = 0x0; address < 0x8000; address += 512) {
            dumpPRG(base, address);
          }
        }
        break;

      case 32:  // 128K/256K
        banks = int_pow(2, prgsize) * 2;
        for (int i = 0; i < banks; i++) {                                  // 128K/256K
          write_prg_byte(0x9000, 1);                                       // PRG Mode 0 - Read $A000-$BFFF to avoid difference between Modes 0 and 1
          write_prg_byte(0xA000, i);                                       // PRG Bank
          for (word address = 0x2000; address < 0x4000; address += 512) {  // 8K Banks ($A000-$BFFF)
            dumpPRG(base, address);
          }
        }
        break;

      case 33:
      case 48:  // 128K/256K
        banks = int_pow(2, prgsize) * 2;
        for (int i = 0; i < banks; i += 2) {
          write_prg_byte(0x8000, i);                                    // PRG Bank 0 ($8000-$9FFF)
          write_prg_byte(0x8001, i + 1);                                // PRG Bank 1 ($A000-$BFFF)
          for (word address = 0x0; address < 0x4000; address += 512) {  // 8K Banks ($8000-$BFFF)
            dumpPRG(base, address);
          }
        }
        break;

      case 35:
      case 90:
      case 209:
      case 211:
        banks = int_pow(2, prgsize) * 2;
        write_prg_byte(0xD000, 0x02);

        for (byte i = 0; i < banks; i++) {
          write_prg_byte(0xD003, (((i >> 5) & 0x06) | 0x20));
          write_prg_byte(0x8000, (i & 0x3f));
          for (word address = 0x0; address < 0x2000; address += 512) {
            dumpPRG(base, address);
          }
        }
        break;

      case 36:
        banks = int_pow(2, prgsize) / 2;
        for (int i = 0; i < banks; i++) {
          write_prg_byte(0xFFA0 + i, (i << 4));
          write_prg_byte(0x4101, 0);
          write_prg_byte(0x4102, (i << 4));
          write_prg_byte(0x4103, 0);
          write_prg_byte(0x4100, 0);
          write_prg_byte(0x4103, 0xFF);
          write_prg_byte(0xFFFF, 0xFF);
          for (word address = 0x0; address < 0x8000; address += 512) {
            dumpPRG(base, address);
          }
        }
        break;

      case 37:
        banks = ((int_pow(2, prgsize) * 2)) - 2;  // Set Number of Banks
        write_prg_byte(0xA001, 0x80);             // Block Register - PRG RAM Chip Enable, Writable
        for (int i = 0; i < banks; i += 2) {      // 256K
          if (i == 0)
            write_prg_byte(0x6000, 0);  // Switch to Lower Block ($0000-$FFFF)
          else if (i == 8)
            write_prg_byte(0x6000, 3);  // Switch to 2nd 64K Block ($10000-$1FFFF)
          else if (i == 16)
            write_prg_byte(0x6000, 4);  // Switch to 128K Block ($20000-$3FFFF)
          write_prg_byte(0x8000, 6);    // PRG Bank 0 ($8000-$9FFF)
          write_prg_byte(0x8001, i);
          write_prg_byte(0x8000, 7);  // PRG Bank 1 ($A000-$BFFF)
          write_prg_byte(0x8001, i + 1);
          for (word address = 0x0; address < 0x4000; address += 512) {
            dumpPRG(base, address);
          }
        }
        for (word address = 0x4000; address < 0x8000; address += 512) {  // Final 2 Banks ($C000-$FFFF)
          dumpPRG(base, address);
        }
        break;

      case 42:
        banks = int_pow(2, prgsize) * 2;
        base = 0x6000;  // 8k switchable PRG ROM bank at $6000-$7FFF
        for (int i = 0; i < banks - 4; i++) {
          write_prg_byte(0xE000, i & 0x0F);
          for (word address = 0x0; address < 0x2000; address += 512) {
            dumpPRG(base, address);
          }
        }
        base = 0x8000;  // last 32k fixed to $8000-$FFFF
        for (word address = 0x0; address < 0x8000; address += 512) {
          dumpPRG(base, address);
        }
        break;

      case 45:                                    // MMC3 Clone with Outer Registers
        banks = ((int_pow(2, prgsize) * 2)) - 2;  // Set Number of Banks
        for (int i = 0; i < banks; i += 2) {      // 128K/256K/512K/1024K
          // set outer bank registers
          write_prg_byte(0x6000, 0x00);               // CHR-OR
          write_prg_byte(0x6000, (i & 0xC0));         // PRG-OR
          write_prg_byte(0x6000, ((i >> 2) & 0xC0));  // CHR-AND,CHR-OR/PRG-OR
          write_prg_byte(0x6000, 0x80);               // PRG-AND
          // set inner bank registers
          write_prg_byte(0x8000, 6);  // PRG Bank 0 ($8000-$9FFF)
          write_prg_byte(0x8001, i);
          for (word address = 0x0; address < 0x2000; address += 512) {
            dumpPRG(base, address);
          }
          // set outer bank registers
          write_prg_byte(0x6000, 0x00);                     // CHR-OR
          write_prg_byte(0x6000, ((i + 1) & 0xC0));         // PRG-OR
          write_prg_byte(0x6000, (((i + 1) >> 2) & 0xC0));  // CHR-AND,CHR-OR/PRG-OR
          write_prg_byte(0x6000, 0x80);                     // PRG-AND
          // set inner bank registers
          write_prg_byte(0x8000, 7);  // PRG Bank 1 ($A000-$BFFF)
          write_prg_byte(0x8001, i + 1);
          for (word address = 0x2000; address < 0x4000; address += 512) {
            dumpPRG(base, address);
          }
        }
        for (word address = 0x4000; address < 0x8000; address += 512) {  // Final 2 Banks ($C000-$FFFF)
          dumpPRG(base, address);
        }
        break;

      case 46:
        banks = int_pow(2, prgsize) / 2;  // 32k banks
        for (int i = 0; i < banks; i++) {
          write_prg_byte(0x6000, (i & 0x1E) >> 1);  // high bits
          write_prg_byte(0x8000, i & 0x01);         // low bit
          for (word address = 0x0; address < 0x8000; address += 512) {
            dumpPRG(base, address);
          }
        }
        break;

      case 52:
        banks = int_pow(2, prgsize);
        write_prg_byte(0xA001, 0x80);  // enable WRAM write
        for (int i = 0; i < banks; i++) {
          write_prg_byte(0x6000, (i & 0x07) | 0x08);
          for (word address = 0x0; address < 0x4000; address += 512) {
            dumpPRG(base, address);
          }
        }
        break;

      case 56:
        banks = int_pow(2, prgsize) * 2;
        for (int i = 0; i < banks; i++) {
          write_prg_byte(0xE000, 1);
          write_prg_byte(0xF000, i);
          for (word address = 0x0; address < 0x2000; address += 512) {
            dumpPRG(base, address);
          }
        }
        break;

      case 57:
        banks = int_pow(2, prgsize);
        for (int i = 0; i < banks; i++) {
          write_prg_byte(0x8800, (i & 0x07) << 5);
          write_prg_byte(0x8000, 0);
          for (word address = 0x0; address < 0x4000; address += 512) {
            dumpPRG(base, address);
          }
        }
        break;

      case 58:
      case 213:
        banks = int_pow(2, prgsize) / 2;
        for (int i = 0; i < banks; i++) {
          write_prg_byte(0x8000 + (i & 0x07), 0x00);
          for (word address = 0x0; address < 0x8000; address += 512) {
            dumpPRG(base, address);
          }
        }
        break;

      case 59:
        banks = int_pow(2, prgsize);
        for (int i = 0; i < banks; i++) {
          write_prg_byte(0x8000 + (i & 0x07) << 4 | 0x80, 0);
          for (word address = 0x0; address < 0x4000; address += 512) {
            dumpPRG(base, address);
          }
        }
        break;

      case 60:
        for (word address = 0; address < 0x4000; address += 512) {
          dumpPRG(base, address);
        }
        for (int i = 0; i < 3; i++) {
          write_prg_byte(0x8D8D, i);
          delay(500);
          for (word address = 0; address < 0x4000; address += 512) {
            dumpPRG(base, address);
          }
        }
        break;

      case 62:
        banks = int_pow(2, prgsize) / 2;
        for (int i = 0; i < banks; i++) {
          write_prg_byte(0x8000 + (i * 512) + ((i & 32) << 1), 0x00);
          for (word address = 0x0; address < 0x8000; address += 512) {
            dumpPRG(base, address);
          }
        }
        break;

      case 66:  // 64K/128K
        banks = int_pow(2, prgsize) / 2;
        for (int i = 0; i < banks; i++) {                               // 64K/128K
          write_prg_byte(0x8000, i << 4);                               // bits 4-5
          for (word address = 0x0; address < 0x8000; address += 512) {  // 32K Banks ($8000-$FFFF)
            dumpPRG(base, address);
          }
        }
        break;

      case 63:  // 3072K total
        banks = int_pow(2, prgsize);
        for (int i = 0; i < 192; i++) {
          write_prg_byte(0x8000 + (i << 2), 0);
          for (word address = 0x0; address < 0x4000; address += 512) {
            dumpPRG(base, address);
          }
        }
        break;

      case 67:  // 128K
        banks = int_pow(2, prgsize);
        for (int i = 0; i < banks; i++) {                               // 128K
          write_reg_byte(0xF800, i);                                    // [WRITE RAM SAFE]
          for (word address = 0x0; address < 0x4000; address += 512) {  // 16K Banks ($8000-$BFFF)
            dumpPRG(base, address);
          }
        }
        break;

      case 68:
      case 73:  // 128K
        banks = int_pow(2, prgsize);
        for (int i = 0; i < banks; i++) {  // 128K
          write_prg_byte(0xF000, i);
          for (word address = 0x0; address < 0x4000; address += 512) {  // 16K Banks ($8000-$BFFF)
            dumpPRG(base, address);
          }
        }
        break;

      case 69:  // 128K/256K
        banks = int_pow(2, prgsize) * 2;
        write_prg_byte(0x8000, 8);                                         // Command Register - PRG Bank 0
        write_prg_byte(0xA000, 0);                                         // Parameter Register - PRG RAM Disabled, PRG ROM, Bank 0 to $6000-$7FFF
        for (int i = 0; i < banks; i++) {                                  // 128K/256K
          write_prg_byte(0x8000, 9);                                       // Command Register - PRG Bank 1
          write_prg_byte(0xA000, i);                                       // Parameter Register - ($8000-$9FFF)
          for (word address = 0x0000; address < 0x2000; address += 512) {  // 8K Banks ($8000-$9FFF)
            dumpPRG(base, address);
          }
        }
        break;

      case 70:
      case 89:
      case 152:  // 64K/128K
        banks = int_pow(2, prgsize);
        for (int i = 0; i < banks; i++) {  // 128K
          write_prg_byte(0x8000, i << 4);
          for (word address = 0x0; address < 0x4000; address += 512) {  // 16K Banks ($8000-$BFFF)
            dumpPRG(base, address);
          }
        }
        break;

      case 71:  // 64K/128K/256K
        banks = int_pow(2, prgsize);
        for (int i = 0; i < banks; i++) {
          write_prg_byte(0xC000, i);
          for (word address = 0x0; address < 0x4000; address += 512) {  // 16K Banks ($8000-$BFFF)
            dumpPRG(base, address);
          }
        }
        break;

      case 72:  // 128K
        banks = int_pow(2, prgsize);
        write_prg_byte(0x8000, 0);                                      // Reset Register
        for (int i = 0; i < banks; i++) {                               // 128K
          write_prg_byte(0x8000, i | 0x80);                             // PRG Command + Bank
          write_prg_byte(0x8000, i);                                    // PRG Bank
          for (word address = 0x0; address < 0x4000; address += 512) {  // 16K Banks ($8000-$BFFF)
            dumpPRG(base, address);
          }
        }
        break;

      case 76:
      case 88:
      case 95:
      case 154:  // 128K
      case 206:  // 32/64/128K
        banks = int_pow(2, prgsize) * 2;
        for (int i = 0; i < banks - 2; i += 2) {
          write_prg_byte(0x8000, 6);
          write_prg_byte(0x8001, i);
          write_prg_byte(0x8000, 7);
          write_prg_byte(0x8001, i | 1);
          for (word address = 0x0; address < 0x4000; address += 512) {
            dumpPRG(base, address);
          }
        }
        for (word address = 0x4000; address < 0x8000; address += 512) {
          dumpPRG(base, address);
        }
        break;

      case 79:
      case 146:
        banks = int_pow(2, prgsize) / 2;
        for (int i = 0; i < banks; i++) {
          write_prg_byte(0x4100, i << 3);
          for (word address = 0x0; address < 0x8000; address += 512) {
            dumpPRG(base, address);
          }
        }
        break;

      case 80:   // 128K
      case 207:  // 256K [CART SOMETIMES NEEDS POWERCYCLE]
        banks = int_pow(2, prgsize) * 2;
        for (int i = 0; i < banks; i += 2) {
          write_prg_byte(0x7EFA, i);      // PRG Bank 0 ($8000-$9FFF)
          write_prg_byte(0x7EFC, i + 1);  // PRG Bank 1 ($A000-$BFFF)
          for (word address = 0x0; address < 0x4000; address += 512) {
            dumpPRG(base, address);
          }
        }
        break;

      case 82:  // 128K
        banks = int_pow(2, prgsize) * 2;
        for (int i = 0; i < banks; i += 2) {
          write_prg_byte(0x7EFA, i << 2);                               // PRG Bank 0 ($8000-$9FFF)
          write_prg_byte(0x7EFB, (i + 1) << 2);                         // PRG Bank 1 ($A000-$BFFF)
          for (word address = 0x0; address < 0x4000; address += 512) {  // 8K Banks ($8000-$BFFF)
            dumpPRG(base, address);
          }
        }
        break;

      case 85:  // 128K/512K
        banks = int_pow(2, prgsize) * 2;
        for (int i = 0; i < banks; i++) {
          write_prg_byte(0x8000, i);                                    // PRG Bank 0 ($8000-$9FFF)
          for (word address = 0x0; address < 0x2000; address += 512) {  // 8K Banks ($8000-$9FFF)
            dumpPRG(base, address);
          }
        }
        break;

      case 86:
      case 140:  // 128K
        banks = int_pow(2, prgsize) / 2;
        for (int i = 0; i < banks; i++) {                               // 128K
          write_prg_byte(0x6000, i << 4);                               // bits 4-5
          for (word address = 0x0; address < 0x8000; address += 512) {  // 32K Banks ($8000-$FFFF)
            dumpPRG(base, address);
          }
        }
        break;

      case 91:
        banks = int_pow(2, prgsize);
        for (int i = 0; i < (banks - 2); i += 2) {
          write_prg_byte(0x7000, (i | 0));
          write_prg_byte(0x7001, (i | 1));
          for (word address = 0x0; address < 0x4000; address += 512) {
            dumpPRG(base, address);
          }
        }
        for (word address = 0x4000; address < 0x8000; address += 512) {
          dumpPRG(base, address);
        }
        break;

      case 92:  // 256K
        banks = int_pow(2, prgsize);
        write_prg_byte(0x8000, 0);                                         // Reset Register
        for (int i = 0; i < banks; i++) {                                  // 256K
          write_prg_byte(0x8000, i | 0x80);                                // PRG Command + Bank
          write_prg_byte(0x8000, i);                                       // PRG Bank
          for (word address = 0x4000; address < 0x8000; address += 512) {  // 16K Banks ($C000-$FFFF)
            dumpPRG(base, address);
          }
        }
        break;

      case 93:
        banks = int_pow(2, prgsize);
        for (int i = 0; i < banks; i++) {
          write_prg_byte(0x6000, i);
          write_prg_byte(0x8000, i << 4 | 0x01);
          for (word address = 0x0; address < 0x4000; address += 512) {
            dumpPRG(base, address);
          }
        }
        break;

      case 94:  // bus conflicts - fixed last bank
        banks = int_pow(2, prgsize);
        busConflict = true;
        for (int i = 0; i < banks - 1; i++) {
          for (int x = 0; x < 0x4000; x++) {
            if (read_prg_byte(0xC000 + x) == (i << 2)) {
              write_prg_byte(0xC000 + x, i << 2);
              busConflict = false;
              break;
            }
          }
          if (busConflict) {
            write_prg_byte(0x8000 + i, i << 2);
          }
          for (word address = 0x0; address < 0x4000; address += 512) {
            dumpPRG(base, address);
          }
        }
        for (word address = 0x4000; address < 0x8000; address += 512) {
          dumpPRG(base, address);
        }
        break;

      case 97:   // fixed first bank
      case 180:  // bus conflicts - fixed fist bank
        banks = int_pow(2, prgsize);
        busConflict = true;
        for (word address = 0x0; address < 0x4000; address += 512) {
          dumpPRG(base, address);
        }
        for (int i = 1; i < banks; i++) {
          for (int x = 0; x < 0x4000; x++) {
            if (read_prg_byte(0x8000 + x) == i) {
              write_prg_byte(0x8000 + x, i);
              busConflict = false;
              break;
            }
          }
          if (busConflict) {
            write_prg_byte(0x8000 + i, i);
          }
          for (word address = 0x4000; address < 0x8000; address += 512) {
            dumpPRG(base, address);
          }
        }
        break;

      case 105:                         // 256K
        write_mmc1_byte(0xA000, 0x00);  // Clear PRG Init/IRQ (Bit 4)
        write_mmc1_byte(0xA000, 0x10);  // Set PRG Init/IRQ (Bit 4) to enable bank swapping
        for (int i = 0; i < 4; i++) {   // PRG CHIP 1 128K
          write_mmc1_byte(0xA000, i << 1);
          for (word address = 0x0; address < 0x8000; address += 512) {  // 32K Banks ($8000-$FFFF)
            dumpPRG(base, address);
          }
        }
        write_mmc1_byte(0x8000, 0x0C);  // Switch 16K Bank ($8000-$BFFF) + Fixed Last Bank ($C000-$FFFF)
        write_mmc1_byte(0xA000, 0x08);  // Select PRG CHIP 2 (Bit 3)
        for (int j = 0; j < 8; j++) {   // PRG CHIP 2 128K
          write_mmc1_byte(0xE000, j);
          for (word address = 0x0; address < 0x4000; address += 512) {  // 16K Banks ($8000-$BFFF)
            dumpPRG(base, address);
          }
        }
        break;

      case 111:
        banks = int_pow(2, prgsize) / 2;
        for (int i = 0; i < banks; i++) {
          write_prg_byte(0x5000, i);
          for (word address = 0x0; address < 0x8000; address += 512) {
            dumpPRG(base, address);
          }
        }
        break;

      case 113:
        banks = int_pow(2, prgsize) / 2;
        for (int i = 0; i < banks; i++) {
          write_prg_byte(0x4100, (i & 0x07) << 3);
          for (word address = 0x0; address < 0x8000; address += 512) {
            dumpPRG(base, address);
          }
        }
        break;

      case 126:
        banks = int_pow(2, prgsize) * 2;
        write_prg_byte(0xA001, 0x80);  // enable WRAM
        write_prg_byte(0x6003, 0x00);  // set MMC3 banking mode
        for (int i = 0; i < banks; i += 2) {
          write_prg_byte(0x6000, (i & 0x180) >> 3 | (i & 0x70) >> 4);  // select outer bank
          write_prg_byte(0x8000, 6);                                   // 8k bank 0 at $8000
          write_prg_byte(0x8001, i);
          write_prg_byte(0x8000, 7);  // 8k bank 1 at $A000
          write_prg_byte(0x8001, i + 1);
          for (word address = 0x0; address < 0x4000; address += 512) {
            dumpPRG(base, address);
          }
        }
        break;

      case 134:
        banks = int_pow(2, prgsize) * 2;
        write_prg_byte(0x6000, 0x00);  // set MMC3 banking mode
        for (int i = 0; i < banks; i += 2) {
          write_prg_byte(0x6001, (i & 0x30) >> 4);  // select outer bank
          write_prg_byte(0x8000, 6);                // 8k bank 0 at $8000
          write_prg_byte(0x8001, i);
          write_prg_byte(0x8000, 7);  // 8k bank 1 at $A000
          write_prg_byte(0x8001, i + 1);
          for (word address = 0x0; address < 0x4000; address += 512) {
            dumpPRG(base, address);
          }
        }
        break;

      case 142:
        banks = int_pow(2, prgsize) * 2;
        base = 0x6000;  // 4x 8k switchable PRG ROM banks at $6000-$DFFF
        for (int i = 0; i < banks; i += 4) {
          write_prg_byte(0xE000, 4);  // Select 8 KB PRG bank at CPU $6000-$7FFF
          write_prg_byte(0xF000, i);
          write_prg_byte(0xE000, 1);  // Select 8 KB PRG bank at CPU $8000-$9FFF
          write_prg_byte(0xF000, i + 1);
          write_prg_byte(0xE000, 2);  // Select 8 KB PRG bank at CPU $A000-$BFFF
          write_prg_byte(0xF000, i + 2);
          write_prg_byte(0xE000, 3);  // Select 8 KB PRG bank at CPU $C000-$DFFF
          write_prg_byte(0xF000, i + 3);
          for (word address = 0x0; address < 0x8000; address += 512) {
            dumpPRG(base, address);
          }
        }
        break;

      case 153:  // 512K
        banks = int_pow(2, prgsize);
        for (int i = 0; i < banks; i++) {                                  // 512K
          write_prg_byte(0x8000, i >> 4);                                  // PRG Outer Bank (Documentation says duplicate over $8000-$8003 registers)
          write_prg_byte(0x8001, i >> 4);                                  // PRG Outer Bank
          write_prg_byte(0x8002, i >> 4);                                  // PRG Outer Bank
          write_prg_byte(0x8003, i >> 4);                                  // PRG Outer Bank
          write_prg_byte(0x8008, i & 0xF);                                 // PRG Inner Bank
          for (word address = 0x0000; address < 0x4000; address += 512) {  // 16K Banks ($8000-$BFFF)
            dumpPRG(base, address);
          }
        }
        break;

      case 157:
        for (int i = 0; i < 15; i++) {
          write_prg_byte(0x8008, i);  // select 16k bank at $8000-$BFFF
          for (word address = 0x0; address < 0x4000; address += 512) {
            dumpPRG(base, address);
          }
        }
        for (word address = 0x4000; address < 0x8000; address += 512) {  // last 16k bank fixed at $C000-$FFFF
          dumpPRG(base, address);
        }
        break;

      case 162:
        banks = int_pow(2, prgsize) / 2;
        write_prg_byte(0x5300, 0x07);  // A16-A15 controlled by $5000
        for (int i = 0; i < banks; i++) {
          write_prg_byte(0x5200, (i & 0x30) >> 4);  // A20-A19
          write_prg_byte(0x5000, i & 0x0F);         // A18-A15
          for (word address = 0x0; address < 0x8000; address += 512) {
            dumpPRG(base, address);
          }
        }
        break;

      case 163:
        banks = int_pow(2, prgsize) / 2;
        write_prg_byte(0x5300, 0x04);  // disable bit swap on writes to $5000-$5200
        for (int i = 0; i < banks; i++) {
          write_prg_byte(0x5200, (i & 0x30) >> 4);  // A20-A19
          write_prg_byte(0x5000, i & 0x0F);         // A18-A15
          for (word address = 0x0; address < 0x8000; address += 512) {
            dumpPRG(base, address);
          }
        }
        break;

      case 174:  // 128k
        for (int i = 0; i < 8; i++) {
          write_prg_byte(0xFF00 + (i << 4), 0);
          for (word address = 0x0; address < 0x4000; address += 512) {
            dumpPRG(base, address);
          }
        }
        break;

      case 176:
        banks = int_pow(2, prgsize) * 2;
        write_prg_byte(0x5FF3, 0);  // extended MMC3 mode: disabled
        write_prg_byte(0x5FF0, 1);  // 256K outer bank mode
        for (int i = 0; i < banks - 3; i += 2) {
          write_prg_byte(0x5FF1, (i & 0xE0) >> 1);  // outer bank select
          write_prg_byte(0x8000, 6);
          write_prg_byte(0x8001, i);
          write_prg_byte(0x8000, 7);
          write_prg_byte(0x8001, i + 1);
          for (word address = 0x0; address < 0x4000; address += 512) {
            dumpPRG(base, address);
          }
        }
        for (word address = 0x4000; address < 0x8000; address += 512) {
          dumpPRG(base, address);
        }
        break;

      case 178:
        banks = int_pow(2, prgsize);
        write_prg_byte(0x4800, 0);  // NROM-256 mode
        write_prg_byte(0x4803, 0);  // set PRG-RAM
        for (int i = 0; i < banks; i += 2) {
          write_prg_byte(0x4802, i >> 3);    // high PRG (up to 8 bits?!)
          write_prg_byte(0x4801, i & 0x07);  // low PRG (3 bits)
          for (word address = 0x0; address < 0x8000; address += 512) {
            dumpPRG(base, address);
          }
        }
        break;

      case 200:
      case 212:
        banks = int_pow(2, prgsize);
        for (int i = 0; i < banks; i++) {
          write_prg_byte(0x8000 + (i & 0x07), 0);
          for (word address = 0x0; address < 0x4000; address += 512) {
            dumpPRG(base, address);
          }
        }
        break;

      case 201:
        banks = int_pow(2, prgsize) / 2;
        for (int i = 0; i < banks; i++) {
          write_prg_byte(0x8000 + (i & 0xFF), 0);
          for (word address = 0x0; address < 0x8000; address += 512) {
            dumpPRG(base, address);
          }
        }
        break;

      case 202:
        banks = int_pow(2, prgsize);
        for (int i = 0; i < banks; i++) {
          write_prg_byte(0x8000 | (i << 1), 0);
          for (word address = 0x0; address < 0x4000; address += 512) {
            dumpPRG(base, address);
          }
        }
        break;

      case 203:
        banks = int_pow(2, prgsize);
        for (int i = 0; i < banks; i++) {
          write_prg_byte(0x8000, (i & 0x1F) << 2);
          for (word address = 0x0; address < 0x4000; address += 512) {
            dumpPRG(base, address);
          }
        }
        break;

      case 210:  // 128K/256K
        banks = int_pow(2, prgsize) * 2;
        for (int i = 0; i < banks; i += 2) {
          write_prg_byte(0xE000, i);      // PRG Bank 0 ($8000-$9FFF) [WRITE NO RAM]
          write_prg_byte(0xE800, i + 1);  // PRG Bank 1 ($A000-$BFFF) [WRITE NO RAM]
          for (word address = 0x0; address < 0x4000; address += 512) {
            dumpPRG(base, address);
          }
        }
        break;

      case 214:
        banks = int_pow(2, prgsize);
        for (int i = 0; i < banks; i++) {
          write_prg_byte(0x8000 | (i << 2), 0);
          for (word address = 0x0; address < 0x4000; address += 512) {
            dumpPRG(base, address);
          }
        }
        break;

      case 225:
      case 255:
        banks = int_pow(2, prgsize);
        for (int i = 0; i < banks; i += 2) {
          write_prg_byte(0x8000 + (((i & 0x40) << 8) | ((i & 0x3F) << 6)), 0);
          for (word address = 0x0; address < 0x8000; address += 512) {
            dumpPRG(base, address);
          }
        }
        break;

      case 226:
        banks = int_pow(2, prgsize);
        for (int i = 0; i < banks; i += 2) {
          write_prg_byte(0x8001, (i & 0x40) >> 6);
          write_prg_byte(0x8000, ((i & 0x20) << 2) | (i & 0x1F));
          for (word address = 0x0; address < 0x8000; address += 512) {
            dumpPRG(base, address);
          }
        }
        break;

      case 227:
        banks = int_pow(2, prgsize) / 2;
        for (int i = 0; i < banks; i++) {
          write_prg_byte(0x8083 + ((i & 0xF) << 3), 0);
          for (word address = 0x0; address < 0x8000; address += 512) {
            dumpPRG(base, address);
          }
        }
        break;

      case 228:
        banks = int_pow(2, prgsize);
        for (int i = 0; i < banks; i += 2) {  // up to 1024k PRG
          write_prg_byte(0x8000 + ((i & 0x3F) << 6), 0);
          for (word address = 0x0; address < 0x8000; address += 512) {
            dumpPRG(base, address);
          }
        }
        if (prgsize > 6) {  // reading the 3rd 512k PRG chip (Action 52)
          for (int i = 0; i < 32; i += 2) {
            write_prg_byte(0x9800 + ((i & 0x1F) << 6), 0);
            for (word address = 0x0; address < 0x8000; address += 512) {
              dumpPRG(base, address);
            }
          }
        }
        break;

      case 229:
        write_prg_byte(0x8000, 0);
        for (word address = 0x0; address < 0x8000; address += 512) {
          dumpPRG(base, address);
        }
        for (int i = 2; i < 32; i++) {
          write_prg_byte(0x8000 + i, i);
          for (word address = 0; address < 0x4000; address += 512) {
            dumpPRG(base, address);
          }
        }
        break;

      case 232:
        banks = int_pow(2, prgsize) / 4;
        for (int outerbank = 0; outerbank < 4; outerbank++) {
          write_prg_byte(0x8000, outerbank << 3);
          for (int i = 0; i < banks; i++) {
            write_prg_byte(0xC000, i);
            for (word address = 0x0; address < 0x4000; address += 512) {
              dumpPRG(base, address);
            }
          }
        }
        break;

      case 235:
        for (int i = 0; i < 32; i++) {
          write_prg_byte(0x8000 + i, 0);
          for (word address = 0x0; address < 0x8000; address += 512) {
            dumpPRG(base, address);
          }
        }
        if (prgsize > 6) {
          for (int i = 32; i < 64; i++) {
            write_prg_byte(0x80E0 + i, 0);
            for (word address = 0x0; address < 0x8000; address += 512) {
              dumpPRG(base, address);
            }
          }
          if (prgsize > 7) {
            for (int i = 64; i < 96; i++) {
              write_prg_byte(0x81E0 + i, 0);
              for (word address = 0x0; address < 0x8000; address += 512) {
                dumpPRG(base, address);
              }
            }
            for (int i = 96; i < 128; i++) {
              write_prg_byte(0x82E0 + i, 0);
              for (word address = 0x0; address < 0x8000; address += 512) {
                dumpPRG(base, address);
              }
            }
          }
        }
        break;

      case 236:
        banks = int_pow(2, prgsize);
        for (int i = 0; i < banks; i++) {
          write_prg_byte(0x8000 | ((i & 0x38) >> 3), 0);  // A19-A17
          write_prg_byte(0xC030 | (i & 0x0F), 0);         // A17-A14
          for (word address = 0x0; address < 0x4000; address += 512) {
            dumpPRG(base, address);
          }
        }
        break;

      case 240:
        banks = int_pow(2, prgsize) / 2;
        for (int i = 0; i < banks; i++) {
          write_prg_byte(0x5FFF, (i & 0xF) << 4);
          for (word address = 0x0; address < 0x8000; address += 512) {
            dumpPRG(base, address);
          }
        }
        break;

      case 242:                         // total size is 640k THIS IS NORMAL
        for (int i = 0; i < 32; i++) {  // dump 1st chip of 512k
          write_prg_byte(0x8400 + (i * 4), 0);
          for (word address = 0x0; address < 0x4000; address += 512) {
            dumpPRG(base, address);
          }
        }
        for (int i = 0; i < 8; i++) {  // dump 2nd chip of 128k
          write_prg_byte(0x8000 + (i * 4), 0);
          for (word address = 0x0; address < 0x4000; address += 512) {
            dumpPRG(base, address);
          }
        }
        break;

      case 246:
        banks = int_pow(2, prgsize) / 2;
        for (int i = 0; i < banks; i += 4) {
          write_prg_byte(0x6000, (i | 0));
          write_prg_byte(0x6001, (i | 1));
          write_prg_byte(0x6002, (i | 2));
          write_prg_byte(0x6003, (i | 3));
          for (word address = 0x0; address < 0x8000; address += 512) {
            dumpPRG(base, address);
          }
        }
        break;
    }
    if (!readrom) {
      myFile.flush();
      myFile.close();

      println_Msg(F("PRG FILE DUMPED!"));
      println_Msg(F(""));
      display_Update();
#ifndef nointro
      printCRC(fileName, &prg_crc32, 0);
#endif
    }
  }
  set_address(0);
  PHI2_HI;
  ROMSEL_HI;
  LED_BLUE_OFF;
}
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
